aryawiandra/despro-2/brag-output/work/maket.jpg

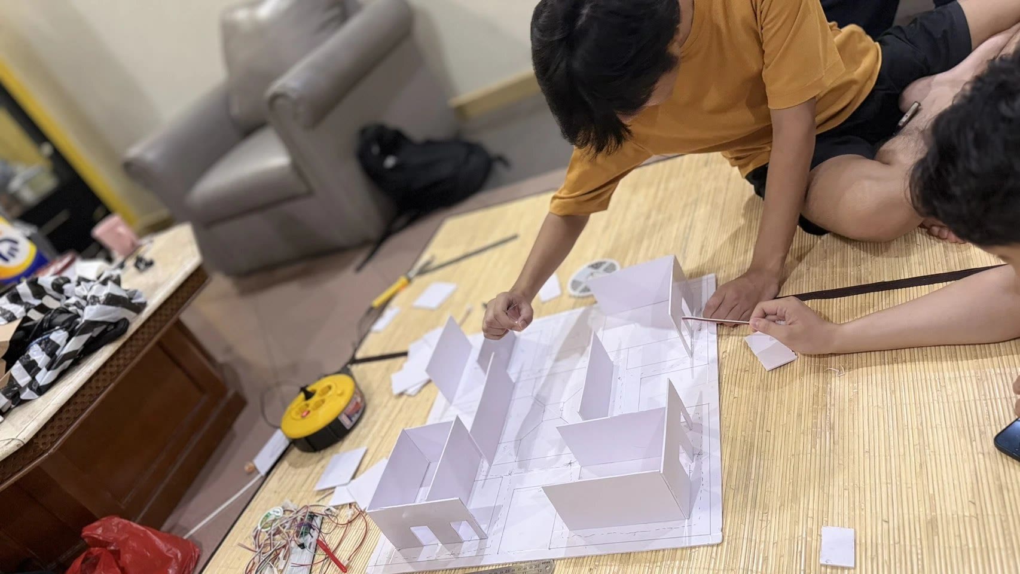
brag-output/work/maket.jpg
