aryawiandra/despro-2/Week4/DOKUM_Maket.jpg

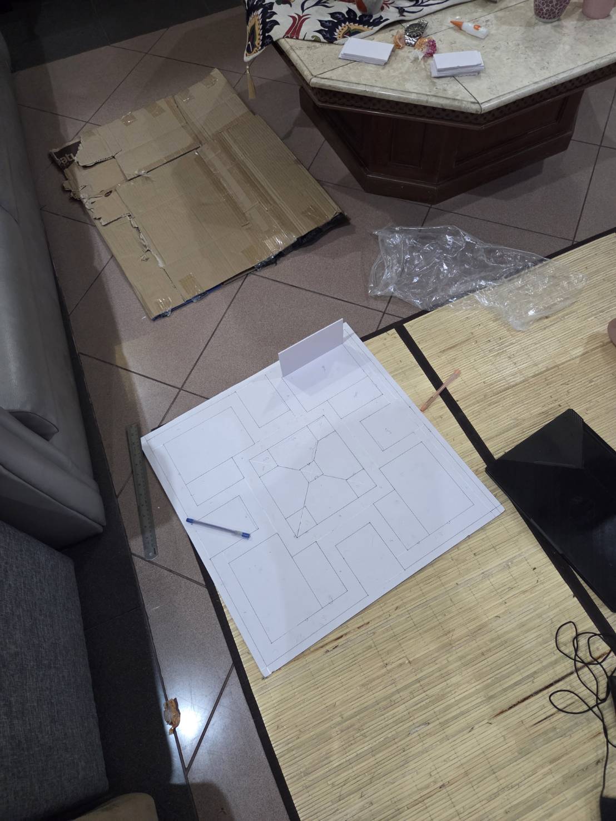
Week4/DOKUM_Maket.jpg
