aryawiandra/despro-2/Week7/README.md

# Week 7 — Navigasi 2 Jalur dengan LED Biasa

LED strip gagal, jadi diganti **LED biasa**. Logic tidak berubah dari
`Week6/espnow/tes_2jalur_*` (ESP-NOW, sender → receiver):

| Kondisi | LED Jalur 1 | LED Jalur 2 |
|---|---|---|
| Tidak ada input / sensor tidak mendeteksi apa-apa | NYALA | NYALA |
| Sensor api jalur 1 kirim `1` (ada api di jalur 1) | **MATI** | nyala |
| Sensor api jalur 2 kirim `1` (ada api di jalur 2) | nyala | **MATI** |
| Kedua jalur terkena api | MATI | MATI (Serial: `[BAHAYA]`) |
| Link ESP-NOW putus > 2 detik | kedip | kedip |

Kode: `led_biasa_2jalur/sender/sender.ino` dan `led_biasa_2jalur/receiver/receiver.ino`
(masing-masing punya `platformio.ini`, buka foldernya di VS Code + PlatformIO).

## Konfigurasi pin

### Receiver (ESP32 #2) — LED jalur

| Fungsi | GPIO ESP32 | Komponen |
|---|---|---|
| LED Jalur 1 | **GPIO 5** | resistor 220 Ω → anoda (+) LED |
| LED Jalur 2 | **GPIO 18** | resistor 220 Ω → anoda (+) LED |
| Ground | **GND** | katoda (−) kedua LED |

```
GPIO5  ──[220Ω]──►|── GND      (LED jalur 1, hijau)
GPIO18 ──[220Ω]──►|── GND      (LED jalur 2, hijau)
```

- Logika **active-HIGH**: pin HIGH (3,3 V) = LED nyala = jalur aman; pin LOW = LED mati = jalur kena api.
- Arus per LED ≈ (3,3 − ~2,0 V) / 220 Ω ≈ 6 mA, aman untuk pin ESP32 (rekomendasi ≤ 12 mA/pin).
- Mau lebih terang / lebih banyak LED per jalur: paralel LED, **tiap LED punya resistor sendiri**,
  dan jaga total arus per pin ≤ ~12 mA (±2 LED per pin). Lebih dari itu pakai transistor (mis. 2N2222/BC547:
  GPIO → 1 kΩ → basis, emitor → GND, LED + resistor ke 5 V lewat kolektor).
- Catu daya: ESP32 dari USB (5 V) atau power bank.

### Sender (ESP32 #1)

| Fungsi | GPIO ESP32 | Keterangan |
|---|---|---|
| Simulasi api | USB / Serial | Tidak butuh wiring — ketik perintah di Serial Monitor (115200) |
| Sensor api jalur 1 (opsional) | **GPIO 32** | Pin **DO** modul flame sensor jalur 1 |
| Sensor api jalur 2 (opsional) | **GPIO 33** | Pin **DO** modul flame sensor jalur 2 |
| Sensor VCC | **3V3** | Jangan 5 V, supaya output DO aman untuk ESP32 |
| Sensor GND | **GND** | |

Sensor hanya dibaca jika `#define USE_FLAME_SENSOR 1` di `sender.ino` (default `0` = simulasi saja).
Output `1` (HIGH) = api terdeteksi. Jika modul sensormu aktif LOW (umum untuk modul flame sensor
LM393), ubah `FLAME_ACTIVE_LEVEL` ke `LOW`.

## Cara simulasi "ada api di jalannya"

1. Upload `receiver.ino` ke ESP32 #2 dan `sender.ino` ke ESP32 #1. Keduanya harus
   `ESPNOW_CHANNEL` sama (1).
2. Buka Serial Monitor sender (115200, line ending **Newline**).
3. Tanpa mengetik apa-apa → kedua LED receiver **nyala**.
4. Ketik `1` (atau `block 1`) → LED jalur 1 **mati** (simulasi api di jalur 1). Ketik `1` lagi / `clear 1` → nyala lagi.
5. Ketik `2` (atau `block 2`) → LED jalur 2 mati. `reset` → kedua nyala lagi.
6. Cabut daya sender > 2 detik → kedua LED receiver berkedip (link putus).

## Catatan

- Kode belum diuji di hardware dari sesi ini (tidak ada ESP32/PlatformIO di lingkungan ini);
  logic diturunkan 1:1 dari Week6 yang sudah dites.
- Folder lama (Week2–Week6) tidak diubah.

---

# Dijkstra + graf 20 jalur (`dijkstra_graph/`)

Graf Week5 (12 junction + 3 exit, 20 jalur, 1 sensor per jalur). Sender menjalankan Dijkstra,
mengirim jalur tercepat ke exit lewat ESP-NOW, receiver menyalakan jalur itu **hijau**.
Input sensor api masih disimulasikan lewat teks di Serial Monitor sender.

- `sender/graph.h` — graf + Dijkstra (C++ murni, sudah diuji di PC)
- `sender/sender.ino` — perintah teks + kirim rute
- `receiver/receiver.ino` — nyalakan jalur rute; `USE_ADDRESSABLE` 0 = LED biasa, 1 = strip addressable

## Perintah di Serial Monitor sender (115200, Newline)

| Perintah | Arti |
|---|---|
| `room 4` | ruangan asal 0–7 (0,1=j1  2,3=j5  4,5=j8  6,7=j11) |
| `start j5` | atau pilih node asal langsung (j1–j12) |
| `block j1-j2` / `block 1` | sensor jalur itu = 1 (ada api), jalur dibuang dari graf |
| `clear j1-j2` | api padam |
| `reset` | semua jalur aman |
| `edges` | daftar 20 jalur: nomor, nama, bobot, status |
| `list` | rute sekarang |

Tiap perubahan: Dijkstra ulang → kirim ke receiver. Jika semua rute ke exit tertutup, semua jalur mati
dan Serial menampilkan `[BAHAYA]`.

## Demo cepat dengan 2 LED (GPIO 5 dan 18, wiring sama seperti di atas)

1. `room 0` → rute j1>j3>j2>e1 (bobot 40). LED GPIO 18 (jalur #2 j1-j3) **nyala**.
2. `block j1-j3` → rute pindah j1>j2>e1 (bobot 54). LED GPIO 18 **mati**, LED GPIO 5 (jalur #1 j1-j2) **nyala**.
3. `block j1-j2` → semua jalan dari j1 tertutup, kedua LED mati, `[BAHAYA]`.
4. `reset` → kembali ke langkah 1.

## 40 LED per jalur

Panjang tiap jalur beda-beda, sementara diasumsikan **40 LED** (`EDGE_LEN[]` di `receiver.ino`, bisa diubah per jalur).

- **Mode LED biasa (default, `USE_ADDRESSABLE 0`)**: 1 pin GPIO per jalur (tabel `EDGE_PIN[]`, `-1` = tidak dipasang).
  Satu pin tidak kuat menyalakan 40 LED (maks ±12 mA/pin), jadi pin menggerakkan transistor/MOSFET
  (mis. GPIO → 1 kΩ → basis 2N2222, LED hijau + resistor tiap LED ke 5 V lewat kolektor) untuk 1 grup 40 LED.
  20 jalur butuh 20 pin; tabel default hanya mengisi jalur #1 (GPIO5) dan #2 (GPIO18) untuk demo di atas.
- **Mode strip addressable (`USE_ADDRESSABLE 1`)**: semua jalur disambung 1 rantai di GPIO 5 (urutan = nomor jalur),
  total 20 × 40 = 800 LED. Butuh library Adafruit NeoPixel dan catu 5 V terpisah (suntik daya tiap beberapa meter);
  hanya jalur rute yang menyala sehingga arus jauh lebih kecil dari 800 LED penuh.

---

# Dijkstra + LED strip WS2812B (`dijkstra_strip/`)

Versi untuk **LED strip addressable** (pengganti `dijkstra_graph` yang LED biasa). Graf, bobot, dan mapping
ruangan sudah dicocokkan dengan `Week4/graph-visualizer.png` dan `Week5/kodeIntegrasi.cpp` (20 jalur identik).

- `sender/` — baca sensor, Dijkstra di `graph.h`. Jalur yang kena api **merah**; **rute tercepat dari setiap ruangan
  ke exit hijau** (beberapa jalur hijau bersamaan); jalur lain mati.
- `receiver/` — jalur hijau dengan kepala terang yang mengalir searah exit (nyala sekuensial, sesuai proposal).
  Link putus: titik biru redup tiap 10 LED.

Perintah sender dan cara upload sama seperti `dijkstra_graph` (`room 0`, `block j1-j3`, `reset`, ...).
Upload: `cd Week7/dijkstra_strip/receiver && pio run -t upload` (idem `sender`).

## Susunan strip: satu pin per jalur

Tiap jalur = 1 strip terpisah (`EDGE_LEN[i]` LED, sementara 40) dengan **pin data sendiri**, tanpa disambung ke strip lain.
Warna tiap LED ditentukan dari data yang dikirim ke pin itu (hijau, merah, atau mati), jadi pin = jalur.

| Jalur | Strip | Pin ESP32 | Jalur | Strip | Pin ESP32 |
|---|---|---|---|---|---|
| #1 | j1-j2 | **GPIO 4** | #11 | j7-j9 | **GPIO 23** |
| #2 | j1-j3 | **GPIO 5** | #12 | j8-j9 | **GPIO 25** |
| #3 | j2-j3 | **GPIO 13** | #13 | j9-j10 | **GPIO 26** |
| #4 | j2-j12 | **GPIO 14** | #14 | j10-j11 | **GPIO 27** |
| #5 | j3-j4 | **GPIO 16** | #15 | j10-j12 | **GPIO 32** |
| #6 | j4-j5 | **GPIO 17** | #16 | j11-j12 | **GPIO 33** |
| #7 | j4-j6 | **GPIO 18** | #17 | j2-e1 | **GPIO 15** (pin boot) |
| #8 | j5-j6 | **GPIO 19** | #18 | j4-e2 | **GPIO 2** (pin boot, LED onboard) |
| #9 | j6-j7 | **GPIO 21** | #19 | j6-e2 | **GPIO 12** (pin boot) |
| #10 | j7-j8 | **GPIO 22** | #20 | j12-e3 | **GPIO 0** (pin boot, tombol BOOT) |

Tabelnya `EDGE_PIN[]` di `receiver.ino` (indeks = nomor jalur − 1); ganti sesuai pin yang kamu pakai.

- **Keterbatasan ESP32:** hanya 16 pin output yang bersih (4, 5, 13, 14, 16–19, 21–23, 25–27, 32, 33). Empat jalur terakhir
  terpaksa memakai pin boot (15, 2, 12, 0). Itu aman selama DIN strip tidak menarik pin ke level tinggi saat reset
  (DIN WS2812B berimpedansi tinggi, ditambah resistor 330 Ω). Kalau **upload gagal** atau ESP32 tidak mau boot,
  cabut kabel data dari GPIO 0, 2, dan 12 sementara.
- **Pin yang jangan dipakai:** GPIO 1 dan 3 (USB serial), 6–11 (flash), 34–39 (hanya input). Kode menolak pin yang tidak valid
  atau ganda dan menampilkan pesan di Serial.
- **Driver output:** library Adafruit NeoPixel hanya bisa melayani 8 pin sekaligus, jadi file ini memakai driver bit-bang
  paralel sendiri yang mengirim ke 20 pin serentak (±1,2 ms per update untuk 40 LED, interrupt dimatikan sebentar).
  Logika bit/pin sudah diuji di PC, tetapi **timing sinyal belum bisa diuji tanpa strip dan ESP32 asli**. Kalau LED berkedip
  acak atau salah warna, lihat bagian "Kalau LED aneh" di bawah.
- **Mode cadangan (`OUTPUT_MODE 0`):** strip digabung dalam rantai DOUT → DIN, tiap rantai 1 pin (`CHAINS[]`), memakai
  library Adafruit (maks 8 rantai). Berguna kalau kekurangan pin.
- Arah data tiap strip = dari node pertama ke node kedua nama jalurnya (jalur #1 mengalir dari j1 ke j2). Jika strip dipasang
  kebalikannya, set `EDGE_REVERSED[i] = true`; animasi tetap searah rute.
- Panjang beda tiap jalur: ubah `EDGE_LEN[i]` (maks `MAX_EDGE_LEN` = 64 LED per jalur).

## Konfigurasi pin dan listrik (receiver)

| Sambungan | Ke |
|---|---|
| ESP32 GPIO sesuai tabel di atas | resistor 330 Ω lalu **DIN** strip jalur yang sesuai (20 kabel data) |
| ESP32 **GND** | GND semua strip **dan** GND catu 5 V (satu ground) |
| Catu **5 V** | +5V tiap strip, langsung dari rel catu (bukan dari pin ESP32) |
| Kapasitor 1000 µF 6,3 V+ | antara +5V dan GND di catu (ESP32 tetap dari USB) |

- Data 3,3 V dari ESP32 biasanya cukup untuk kabel pendek. Kalau LED berkedip acak atau salah warna, pasang level shifter
  (74HCT245 atau 74AHCT125) di jalur data.
- Catu 5 V 30 A sesuai proposal. Hanya jalur hijau/merah yang menyala dan `LED_BRIGHTNESS` 60/255, jadi arus nyata jauh
  di bawah 800 LED penuh (±16 A).

**Kalau LED aneh:** (1) pastikan GND catu dan GND ESP32 tersambung; (2) pasang resistor 330 Ω di tiap kabel data;
(3) coba level shifter 74HCT245; (4) kurangi `LED_BRIGHTNESS`; (5) uji dulu 1 strip di GPIO 4 (jalur #1).

## Parameter di `receiver.ino`

`ANIMATE` (1 = kepala berjalan, 0 = hijau diam), `CHASE_LEN`, `CHASE_STEP_MS`, `SHOW_BLOCKED_RED`
(1 = jalur kena api merah), `LED_BRIGHTNESS`.

## Tes cepat dengan 1 strip pendek

Tanpa merakit 20 jalur: sambungkan **1 strip** (mis. 40 LED) ke **GPIO 4** (jalur #1).
Di sender: `block j1-j3` → jalur #1 (j1>j2) menyala hijau dengan kepala berjalan. `reset` → jalur #1 mati lagi (karena j1>j3
kembali jadi pilihan terbaik). Jalur #2 (j1-j3) merah hanya terlihat bila strip kedua dipasang di GPIO 5.

Logic diuji di PC (Dijkstra, urutan/arah rute, render pixel receiver, link putus); belum diuji di ESP32 asli.

---

# KONFIGURASI AKHIR — `dijkstra_strip` dengan 20 sensor api (2 ESP32)

Alur: 20 sensor api (1 per jalur, langsung ke GPIO, tanpa multiplexer) → **ESP32 #1 sender** (baca sensor, Dijkstra) → ESP-NOW → **ESP32 #2 receiver**
(LED strip 20 jalur × 40 LED). Jalur rute hijau, jalur kena api dibuang dari graf dan rute otomatis dihitung ulang.

## ESP32 #1 — SENDER (20 sensor langsung ke GPIO + Dijkstra)

Tanpa multiplexer: tiap sensor api (pin **DO** modul) disambung ke **1 pin GPIO** sendiri. Tabelnya ada di
`SENSOR_PIN[]` di `sender.ino` (indeks = nomor jalur − 1).

| Jalur | Sensor di | GPIO | Jalur | Sensor di | GPIO |
|---|---|---|---|---|---|
| #1 | j1-j2 | **4** | #11 | j7-j9 | **25** |
| #2 | j1-j3 | **13** | #12 | j8-j9 | **26** |
| #3 | j2-j3 | **14** | #13 | j9-j10 | **27** |
| #4 | j2-j12 | **16** | #14 | j10-j11 | **32** |
| #5 | j3-j4 | **17** | #15 | j10-j12 | **33** |
| #6 | j4-j5 | **18** | #16 | j11-j12 | **34** * |
| #7 | j4-j6 | **19** | #17 | j2-e1 | **35** * |
| #8 | j5-j6 | **21** | #18 | j4-e2 | **36 (VP)** * |
| #9 | j6-j7 | **22** | #19 | j6-e2 | **39 (VN)** * |
| #10 | j7-j8 | **23** | #20 | j12-e3 | **15** ** |

\* GPIO 34, 35, 36, 39 hanya input dan **tidak punya pull-up internal**: pasang resistor **10 kΩ dari pin itu ke 3V3**
(4 resistor). Sensor lain memakai pull-up internal ESP32 (`INPUT_PULLUP`).
\** GPIO 15 adalah pin strapping: aman karena sensor aktif LOW dan idle-nya HIGH saat boot (kalau ada api saat boot,
paling-paling log boot di Serial tidak tampil). Pin yang sengaja **tidak dipakai**: 0, 1, 2, 3, 5, 6–12 (boot, UART USB, flash).

Tiap modul sensor: `VCC` → rel 3,3 V, `GND` → GND, `DO` → GPIO di tabel (pin `AO` tidak dipakai). Modul umumnya
**aktif LOW** (DO = 0 saat ada api), sesuai `SENSOR_ACTIVE_LEVEL LOW`; kalau modulmu aktif HIGH, ubah ke `HIGH`.
Cek label pin di board-mu: beberapa board 30-pin tidak memunculkan semua GPIO di atas (mis. 36/39 berlabel VP/VN).
Pin bisa diganti seenaknya di `SENSOR_PIN[]` (hindari pin terlarang di atas).

**Catatan daya sensor:** 20 modul ≈ 15–20 mA tiap modul ≈ 0,3–0,4 A. Itu terlalu berat untuk regulator 3V3 di board
ESP32 saat WiFi aktif. Pakai regulator/buck **3,3 V terpisah (≥1 A)** dari catu 5 V untuk rel sensor, GND-nya
**disambung** ke GND ESP32. Jangan beri sensor 5 V: output DO bisa 5 V dan melebihi batas pin ESP32 (3,3 V).
Kabel: 20 sensor × 3 kawat; pakai terminal block / PCB bolong untuk rel 3,3 V dan GND bersama.

Sensor yang belum dipasang: set `-1` di `SENSOR_PIN[]` untuk jalur itu (tidak dibaca, selalu "aman").

## ESP32 #2 — RECEIVER (LED strip)

20 strip, **1 pin data per strip** (tabel pin di bagian "Susunan strip: satu pin per jalur"): GPIO → resistor 330 Ω → DIN strip.
GND ESP32 disambung ke GND semua strip dan GND catu 5 V. Strip dapat +5V langsung dari catu 5 V (30 A di proposal), kapasitor
1000 µF antara +5V dan GND. Tiap jalur 40 LED (`EDGE_LEN[]`, `EDGE_REVERSED[]` bila ada strip terpasang kebalikan).
ESP32 receiver cukup dari USB.

## Input ruangan asal

Default (`room all`): rute tercepat dari setiap ruangan (0–7, lewat junction j1, j5, j8, j11) ke exit dihitung sekaligus,
jadi tidak perlu memilih ruangan — 10 jalur hijau saat aman, dan berubah otomatis saat ada api.
Serial sender mencetak rute tercepat **tiap ruangan** ke exit terdekatnya beserta bobotnya (bobot jalur + 1 untuk penghubung ruangan), mis. `Ruang 0: j1 > j3 > j2 > e1 (bobot 41)`. Untuk melihat rute satu ruangan saja: `room N`
(0,1 → j1; 2,3 → j5; 4,5 → j8; 6,7 → j11) atau `start j5`; `room all` kembali ke default.
Ubah default lewat `DEFAULT_SHOW_ALL` di `sender.ino`. Junction yang terputus dari semua exit dicetak di Serial
(`Ruangan di junction ini TERPUTUS dari exit`).

## Upload dan jalankan

```
cd "Week7/dijkstra_strip/receiver" && pio run -t upload      # colok ESP32 receiver
cd "Week7/dijkstra_strip/sender"   && pio run -t upload && pio device monitor   # colok ESP32 sender
```

Perintah di monitor sender: `sensors` (bacaan mentah 20 sensor), `edges`, `list`, `room N`, serta simulasi tanpa
sensor `block j1-j3` / `clear j1-j3` / `reset`.

## Urutan tes sebelum demo

1. **Sensor:** ketik `sensors` di monitor sender. Semua jalur harus `aman`. Dekatkan api ke satu sensor: baris jalur itu
   jadi `API` dan monitor menampilkan `[SENSOR] api di: ...`. Kalau ada jalur yang `API` padahal tidak ada api: cek pull-up
   10 kΩ (untuk GPIO 34/35/36/39), polaritas `SENSOR_ACTIVE_LEVEL`, atau pin yang salah sambung.
2. **Rute:** tanpa api, 10 jalur hijau (j1>j3, j3>j2, j2>e1, j5>j4, j4>e2, j8>j7, j7>j6, j6>e2, j11>j12, j12>e3). Dekatkan api ke sensor j1-j3 → jalur #2 **merah**
   dan j1 berpindah ke j1>j2 (hijau) dalam < 1 detik.
3. **Receiver:** jalur hijau dengan kepala terang mengalir menuju exit; jalur api merah; jalur lain mati.
4. **Semua tertutup:** api di semua jalan keluar (j2-e1, j4-e2, j6-e2, j12-e3) → `[BAHAYA]` di sender, tidak ada jalur hijau, jalur api merah.
5. **Link putus:** cabut sender > 2 detik → receiver menampilkan titik biru redup di tiap jalur.

Logic (Dijkstra, scan + debounce sensor, pemetaan pin ke jalur, render receiver) sudah diuji di PC dengan mock;
rangkaian dan strip asli belum diuji di sesi ini.

---

# UJI 5 STRIP (`dijkstra_5jalur/`) — peta lengkap, 5 strip LED, 5 pin, 5 sensor

Folder `dijkstra_5jalur/` adalah **kode baru khusus uji 5 jalur / 5 pin**. Kode 20 jalur (`dijkstra_strip/`), `dijkstra_graph/`,
dan `led_biasa_2jalur/` tidak diubah.

**Cara kerja:** Dijkstra tetap berjalan di **peta lengkap 20 jalur** (sender, `graph.h`). Strip LED fisik hanya ada di 5 jalur
dengan panjang berbeda, dan receiver hanya menampilkan 5 jalur itu. Sensor api asli juga hanya di 5 jalur itu.

**Input api HANYA dari sensor AO.** Simulasi lewat teks (`block` / `clear` / `reset`) dimatikan secara default
(`ALLOW_TEXT_SIM 0` di `sender.ino`) dan menjawab pesan penolakan. Jalur tanpa sensor tidak pernah dianggap kena api, jadi
hanya api di 5 jalur bersensor yang mengubah rute. Untuk uji tanpa sensor, set `ALLOW_TEXT_SIM 1` lalu upload ulang sender.

| Jalur | Nama | Bobot | LED | Strip (receiver) | Sensor api (sender) |
|---|---|---|---|---|---|
| #3 | j2-j3 | 12 | **7** | **GPIO 4** → 330 Ω → DIN | **GPIO 32** ← AO |
| #11 | j7-j9 | 12 | **8** | **GPIO 5** → 330 Ω → DIN | **GPIO 33** ← AO |
| #15 | j10-j12 | 12 | **8** | **GPIO 13** → 330 Ω → DIN | **GPIO 34** ← AO |
| #18 | j4-e2 | 6 | **6** | **GPIO 14** → 330 Ω → DIN | **GPIO 35** ← AO |
| #19 | j6-e2 | 6 | **5** | **GPIO 18** → 330 Ω → DIN | **GPIO 36 (VP)** ← AO |

Total 34 LED. Panjang LED ada di `STRIPS[]` (`receiver.ino`); pin sensor di `SENSOR_PIN[]` (`sender.ino`).
GPIO 16 dan 17 tidak dipakai (berlabel RX2 / TX2 di banyak board).

## Tampilan

| Kondisi jalur | Tampilan strip |
|---|---|
| Aman, menuju exit (rute tercepat dari ruangan) | **Hijau** redup + kepala terang yang berjalan sekuensial searah exit |
| Kena api (sensor atau teks = 1) | **Merah berkedip** (nyala 400 ms, padam 400 ms) |
| Aman tapi bukan rute | Mati |
| Link putus > 2 detik | Titik biru redup tiap 10 LED |

Parameter di `receiver.ino`: `BLINK_MS`, `ANIMATE` (0 = hijau diam), `CHASE_LEN`, `CHASE_STEP_MS`, `LED_BRIGHTNESS`.

## Skenario (hasil tes di PC; `room all`, semua ruangan dipandu ke exit terdekat)

Kolom pertama menyebut sumber api. Baris bertanda *(teks)* hanya bisa dicoba dengan `ALLOW_TEXT_SIM 1`, karena jalur itu tidak punya sensor.

| Api di (cara) | Strip hijau | Strip merah berkedip | Keterangan |
|---|---|---|---|
| tanpa api | #3, #18, #19 | – | ruang 0,1: j1>j3>j2>e1; ruang 2,3: j5>j4>e2; ruang 4,5: j8>j7>j6>e2 |
| j6-j7 (#9, teks) | #3, #11, #15, #18 | – | ruang 4,5 pindah ke e3 lewat j8>j7>j9>j10>j12>e3; #19 mati |
| j7-j8 (#10, teks) | #3, #15, #18 | – | ruang 4,5 lewat j8>j9>j10>j12>e3 |
| j2-e1 (#17, teks) | #18, #19 | – | ruang 0,1 pindah lewat j3>j4>e2; #3 mati |
| j4-e2 (#18, sensor) | #3, #19 | #18 | ruang 2,3 lewat j5>j4>j6>e2 |
| j6-e2 (#19, sensor) | #3, #18 | #19 | ruang 4,5 lewat j8>j7>j6>j4>e2 |
| j4-e2 dan j6-e2 | #3 | #18, #19 | tinggal jalur ke e1 dan e3 |

## Rangkaian ESP32 #2 — RECEIVER (5 strip)

| Dari | Ke |
|---|---|
| GPIO 4 | resistor 330 Ω → **DIN** strip #3 (j2-j3, 7 LED) |
| GPIO 5 | resistor 330 Ω → **DIN** strip #11 (j7-j9, 8 LED) |
| GPIO 13 | resistor 330 Ω → **DIN** strip #15 (j10-j12, 8 LED) |
| GPIO 14 | resistor 330 Ω → **DIN** strip #18 (j4-e2, 6 LED) |
| GPIO 18 | resistor 330 Ω → **DIN** strip #19 (j6-e2, 5 LED) |
| GND ESP32 | GND semua strip |
| Pin VIN / 5V ESP32 (rel USB 5 V) | +5V semua strip (paralel) |
| Kapasitor 470–1000 µF | antara +5V dan GND di dekat strip (kaki panjang ke +5V) |
| USB ESP32 | laptop |

Arah data strip = dari node pertama ke node kedua nama jalur (#3 mengalir dari j2 ke j3). Kalau terpasang kebalikannya,
set `reversed = true` di `STRIPS[]`. Kalau LED berkedip acak atau salah warna: pasang level shifter 74HCT245 di tiap kabel data.

## Rangkaian ESP32 #1 — SENDER (5 sensor, pin AO analog)

| Sensor di jalur | Pin **AO** sensor ke |
|---|---|
| #3 j2-j3 | GPIO 32 |
| #11 j7-j9 | GPIO 33 |
| #15 j10-j12 | GPIO 34 |
| #18 j4-e2 | GPIO 35 |
| #19 j6-e2 | GPIO 36 (berlabel VP / SVP) |
| VCC semua sensor | **3V3** ESP32 (jangan 5 V) |
| GND semua sensor | GND ESP32 |

- **Pin harus ADC1** (GPIO 32, 33, 34, 35, 36, 39). Pin ADC2 (4, 12–15, 25–27) tidak bisa dibaca analog saat WiFi/ESP-NOW aktif,
  dan sender memakai ESP-NOW. Cadangan: GPIO 39 (berlabel VN / SVN). Tidak perlu pull-up. Kode memberi peringatan di Serial
  kalau ada pin sensor yang bukan ADC1.
- **VCC sensor harus 3,3 V**: pada 5 V pin AO bisa mencapai 5 V dan merusak ADC ESP32. Pin `DO` tidak dipakai.
- **Ambang api**: nilai ADC 12-bit (0–4095). Seperti `Week4/kodeUpdated.cpp`, api bila nilai **< 1500** (`SENSOR_FIRE_BELOW`);
  kembali aman bila nilai **> 1800** (`SENSOR_CLEAR_ABOVE`, histeresis anti-kedip). Tiap scan memakai rata-rata 8 pembacaan,
  dan status baru berubah setelah 3 scan berturut-turut (±150 ms).
- **Kalibrasi**: ketik `sensors` di Serial Monitor sender untuk melihat nilai ADC tiap sensor, misalnya
  `#19 j6-e2 AO GPIO 36 nilai=3900 (api bila < 1500)`. Catat nilai saat tanpa api dan saat api didekatkan, lalu atur
  `SENSOR_FIRE_BELOW` / `SENSOR_CLEAR_ABOVE` di `sender.ino` di antara kedua nilai itu. Tiap modul bisa berbeda.

Jalur lain (tanpa sensor, pin = -1) tidak pernah dianggap kena api (kecuali `ALLOW_TEXT_SIM 1`).

Perintah sender (Serial Monitor 115200, Newline): `room all`, `room N`, `start <node>`, `edges`, `sensors` (nilai ADC), `list`, `help`.
(`block`, `clear`, `reset` hanya aktif bila `ALLOW_TEXT_SIM 1`.)
Upload: `cd Week7/dijkstra_5jalur/receiver && pio run -t upload` (idem `sender`).

## Pengiriman ESP-NOW (tidak spam)

Sender **tidak mengirim terus-menerus**. Paket dikirim hanya saat:
- ada perubahan (sensor api berubah atau perintah teks seperti `block` / `clear` / `reset` / `room`),
- sender baru menyala,
- receiver meminta data (receiver baru menyala atau di-reset).

Tiap kejadian dikirim **3 kali berselang 100 ms** (`SEND_REPEATS`, `SEND_REPEAT_MS`), karena ESP-NOW broadcast tidak ada ACK
dan 1 paket bisa hilang. Setelah itu sender diam. Hasil tes di PC: boot 3 paket, idle 2 menit 0 paket, tiap perubahan 3 paket.
`list`, `edges`, `sensors` tidak mengirim apa pun. Pesan `SEND ERROR` dibatasi maksimal 1× per 5 detik.

Receiver yang baru menyala meminta status ke sender (paket 1 byte `REQUEST_MAGIC`, tiap 1,5 detik) **hanya selama belum ada
data**, lalu berhenti. Jadi receiver yang dinyalakan belakangan tetap langsung menampilkan kondisi terbaru.

Akibatnya **tidak ada deteksi link putus** (receiver tidak tahu kalau sender mati). Kalau butuh: di sender set `HEARTBEAT_MS 1000`
dan di receiver `LINK_TIMEOUT_MS 3500`; strip akan menampilkan titik biru redup bila sender tidak terdengar.

## Daya: cukup dari laptop?

**Ya, untuk uji ini cukup dari USB laptop**, karena hanya 34 LED. Perkiraan (WS2812B, `LED_BRIGHTNESS` 60/255, 20 mA per warna
pada kecerahan penuh):

| Beban | Arus kira-kira |
|---|---|
| 34 LED merah menyala semua (skenario terburuk) | ±0,16 A |
| Hijau redup + kepala terang (normal) | ±0,05–0,1 A |
| LED mati (±1 mA/LED) | ±0,03 A |
| ESP32 receiver (WiFi) | ±0,15–0,25 A |
| **Total terburuk receiver** | **±0,45 A** (di bawah 0,5 A port USB 2.0) |
| ESP32 sender + 5 sensor | ±0,35 A |

Syaratnya `LED_BRIGHTNESS` tetap ≤ 60. Kalau dinaikkan ke 255, merah penuh 34 LED bisa menarik ±0,7 A dan melewati batas USB.
Kalau ESP32 receiver reset sendiri atau LED berkedip acak, pakai power bank atau catu 5 V ≥ 1 A untuk strip (GND disambung ke ESP32).
Angka di atas perkiraan dari datasheet, bukan hasil ukur.

---

# UJI 3 JALUR (`dijkstra_3jalur/`)

Turunan `dijkstra_5jalur/`: **3 strip LED dan 3 sensor api asli (pin AO)**. **Input api hanya dari sensor AO**:
simulasi teks dimatikan (`ALLOW_TEXT_SIM 0` di `sender.ino`), jalur tanpa sensor tidak pernah dianggap kena api. Dijkstra memakai peta lengkap 20 jalur; kode 5 jalur dan
20 jalur tidak diubah.

| Sensor | Jalur | LED | Pin strip (receiver) | Pin sensor AO (sender) |
|---|---|---|---|---|
| 1 | #3 j2-j3 | 7 | **GPIO 5 (D5)** → 330 Ω → DIN | **GPIO 32** |
| 2 | #18 j4-e2 | 6 | **GPIO 13 (D13)** → 330 Ω → DIN | **GPIO 33** |
| 3 | #19 j6-e2 | 5 | **GPIO 14 (D14)** → 330 Ω → DIN | **GPIO 34** |

Total 18 LED. Receiver: GND bersama, +5 V dari USB, kapasitor 470–1000 µF. Sender: VCC sensor 3,3 V (bukan 5 V), GND bersama,
pin AO ke GPIO 32/33/34 (ADC1, tanpa pull-up). Api bila nilai ADC < 1500, aman lagi bila > 1800 (`sensors` menampilkan nilai untuk kalibrasi).

Perintah (Serial Monitor 115200, Newline): `sensors` (nilai ADC + status), `room all`, `room N`, `start <node>`, `edges`, `list`, `help`.
`sensor`, `block`, `clear`, `reset` hanya aktif bila `ALLOW_TEXT_SIM 1` lalu upload ulang sender (untuk uji tanpa sensor).
Contoh: api didekatkan ke sensor 3 → jalur #19 merah berkedip, ruang 4,5 pindah rute.

Upload: `cd Week7/dijkstra_3jalur/receiver && pio run -t upload` (idem `sender`).
Sintaks sender dicek dengan compiler PC (mock Arduino); belum dikompilasi PlatformIO dan belum diuji di ESP32 dari sesi ini.

---

# UJI 6 JALUR (`dijkstra_6jalur/`)

Turunan `dijkstra_3jalur/` (kode 3 jalur tidak diubah): **6 strip LED dan 6 sensor api asli (pin AO)**. Power supply 5 V sudah bisa dipakai.
Tiga jalur pertama memakai pin yang sama dengan uji 3 jalur, jadi wiring lama tidak perlu dibongkar; tiga jalur baru ditambahkan.

| Sensor | Jalur | LED | Pin strip (receiver) | Pin sensor (sender) | Keterangan |
|---|---|---|---|---|---|
| 1 | #3 j2-j3 | 7 | **GPIO 5 (D5)** → 330 Ω → DIN | **GPIO 32** | sama dengan uji 3 jalur |
| 2 | #18 j4-e2 | 6 | **GPIO 13 (D13)** → 330 Ω → DIN | **GPIO 33** | sama dengan uji 3 jalur |
| 3 | #19 j6-e2 | 5 | **GPIO 14 (D14)** → 330 Ω → DIN | **GPIO 34** | sama dengan uji 3 jalur |
| 4 | #11 j7-j9 | 8 | **GPIO 4 (D4)** → 330 Ω → DIN | **GPIO 35** (AO) | baru |
| 5 | #15 j10-j12 | 8 | **GPIO 18 (D18)** → 330 Ω → DIN | **GPIO 25** (DO digital) | baru |
| 6 | #20 j12-e3 | 5 | **GPIO 19 (D19)** → 330 Ω → DIN | **GPIO 26** (DO digital) | baru, exit e3 |

Total 39 LED. Perkiraan arus terburuk (merah semua, `LED_BRIGHTNESS` 60) ±0,5 A, diskalakan dari estimasi 0,45 A untuk 34 LED, bukan hasil ukur.
Strip dicatu dari power supply 5 V dengan GND bersama ESP32 dan kapasitor 470–1000 µF; sensor VCC 3,3 V. Board hanya punya GPIO sampai 35 (tanpa VP/VN = GPIO 36/39) dan ADC2 tidak bisa dibaca saat ESP-NOW aktif, jadi pin AO (ADC1) cuma
GPIO 32, 33, 34, 35 untuk sensor 1-4. Sensor 5 dan 6 dibaca **digital dari pin DO** modul (GPIO 25 dan 26): tanpa ADC, ambang api diatur
dengan potensiometer di modul (putar sampai LED DO menyala saat ada api). Modul LM393 umumnya DO = LOW saat api; bila terbalik ubah
`SENSOR_DIGITAL_FIRE_LEVEL` di `sender.ino`. Sensor 5-6 tidak punya nilai ADC, jadi `sensors` menampilkan status pin HIGH/LOW.
Alternatif bila perlu sensor analog lebih banyak: multiplexer CD74HC4067 (sudah ada di rancangan proposal) pada satu pin ADC1.

Pilihan jalur #11, #15, #20 adalah usulan (tiga exit tercakup: e1 lewat jalur lain, e2 lewat #18/#19, e3 lewat #20). Mau jalur lain: ubah `STRIPS[]` di
`receiver.ino` serta `SENSOR_EDGE[]` dan `SENSOR_PIN[]` di `sender.ino`.

Perintah tambahan dibanding 3 jalur: `sensor <1-6> 1|0` (simulasi teks sensor 1..6) dan `sensors` menampilkan 6 nilai ADC.
Upload: `cd Week7/dijkstra_6jalur/receiver && pio run -t upload` (idem `sender`).
Sintaks sender dan receiver dicek dengan compiler PC (mock Arduino, tanpa error/warning); belum dikompilasi PlatformIO dan belum diuji di ESP32 dari sesi ini.
