aryawiandra/despro-2/Week7/Individu_LAPORAN PEKANAN.docx

# LAPORAN PEKANAN INDIVIDU

## Capstone Project Desain Proyek 2

### A. Identitas Mahasiswa

Item | Keterangan
Nama | Muhammad Arya Wiandra Utomo
NPM | 2306218295
Program Studi | Teknik Komputer
Kelompok | 21
Judul Proyek | SAFE-EXIT: Adaptive Fire-Evacuation Path Lighting System
Pekan ke- | 7
Periode Tanggal | 5 – 10 Oktober 2026
Dosen Pembimbing | Dr. Eng. Mia Rizkinia, S.T., M.T.

## B. Target Mingguan

Target yang direncanakan pada awal pekan berdasarkan WBS dan pembagian tugas kelompok.

No | Target Pekerjaan | Luaran yang Diharapkan | Status
1 | Menyolder LED strip WS2812B untuk maket | Seluruh LED strip tersolder | ☑ Selesai
2 | Menyelesaikan kode prototipe penuh dan scaling ke 20 jalur | Kode sender + receiver 20 jalur, versi uji 5 jalur dan 3 jalur di repository | ☑ Selesai
3 | Menguji integrasi penuh 20 jalur dengan power supply | Seluruh jalur menyala sesuai rute | ☐ Belum
4 | Menguji 3 jalur (sensor, Dijkstra, ESP-NOW, LED) | Hasil uji 3 jalur | ☑ Selesai
5 | Mendokumentasikan spesifikasi sensor api | Tabel spesifikasi sensor di laporan | ☑ Selesai

## C. Logbook Aktivitas Harian

Hari/Tanggal | Uraian Aktivitas | Waktu (Jam) | Bukti/Dokumen
Senin, 5 Oktober 2026 | Rapat tim awal pekan; breakdown tugas Pekan 7 (solder LED, kode prototipe, integrasi) | 2 | Catatan rapat
Selasa, 6 Oktober 2026 | Menyolder LED strip dan kabel data bersama tim | 3 | Foto LED tersolder (Gambar 1)
Rabu, 7 Oktober 2026 | Menyolder LED strip; menyiapkan pemetaan pin 20 jalur | 3 | Foto LED tersolder; tabel pin
Kamis, 8 Oktober 2026 | Menyusun kode Dijkstra 20 jalur dan receiver strip per jalur | 4 | Source code Week7/dijkstra_strip
Jumat, 9 Oktober 2026 | Kendala: arus uji 5 jalur kurang kuat dan konektor power supply bermasalah; memutuskan uji disederhanakan menjadi 3 jalur | 3 | Catatan kendala
Sabtu, 10 Oktober 2026 | Menulis dan menguji kode 3 jalur (sensor AO GPIO 32/33/34, strip GPIO 5/13/14, ESP-NOW hemat paket, merah berkedip); menyusun spesifikasi sensor, laporan, dan PPT | 6 | Commit Week7/dijkstra_3jalur (Gambar 3); laporan

### Total Jam Kerja Minggu Ini : 21 Jam

## D. Realisasi Pekerjaan

### 1. Aktivitas yang Berhasil Diselesaikan

- Ikut menyolder LED strip WS2812B untuk 20 jalur sampai selesai.
- Menyelesaikan kode prototipe penuh dan scaling ke 20 jalur: graf 15 simpul / 20 jalur, Dijkstra multi-sumber dari exit, rute tercepat tiap ruangan, receiver strip per jalur dengan kepala terang bergerak ke exit, dan pengiriman ESP-NOW.
- Menyusun versi uji 5 jalur (dijkstra_5jalur) dan versi uji 3 jalur (dijkstra_3jalur): Dijkstra pada peta lengkap, 3 strip fisik (18 LED) pada GPIO 5, 13, 14, 3 sensor api via pin AO ADC1 (GPIO 32, 33, 34) dengan ambang 1500 / histeresis 1800, merah berkedip, dan ESP-NOW yang hanya mengirim saat ada perubahan. Input api hanya dari sensor AO (simulasi teks dimatikan).
- Menguji 3 jalur sampai berhasil (sensor hingga LED) setelah uji 5 jalur terkendala arus catu yang kurang kuat dan konektor power supply; mendokumentasikan spesifikasi sensor api; menyusun laporan dan PPT Pekan 7.

### 2. Luaran yang Dihasilkan

- Source code Week7/dijkstra_strip (20 jalur), Week7/dijkstra_5jalur, dan Week7/dijkstra_3jalur (uji 3 jalur berhasil) di repository tim
- LED strip 20 jalur yang telah disolder (kontribusi tim)
- README Week7: pemetaan pin, rangkaian, perkiraan daya, skenario uji
- Spesifikasi sensor api (tabel pada bagian E laporan ini)
- Laporan kelompok, laporan individu, dan PPT Pekan 7

## E. Capaian Teknis Mingguan

### Komponen/Subsistem yang Dikerjakan (pilih sesuai tugas)

Subsistem | Target | Realisasi | Persentase
Hardware | Menyolder LED strip dan menyiapkan rangkaian maket | LED strip 20 jalur selesai disolder; rangkaian 3 jalur berhasil; uji 5 jalur terkendala arus; 20 jalur menunggu konektor PSU | 70%
Software | Kode prototipe penuh dan scaling 20 jalur | Sender + receiver 20 jalur selesai; versi uji 3 jalur berhasil berjalan | 95%
Mekanik | Pemasangan LED dan sensor pada maket | LED dan sensor 3 jalur siap ditempel pada maket; menunggu penempelan | 30%
Pengujian | Uji integrasi 20 jalur dengan power supply | Uji 3 jalur berhasil; 20 jalur menunggu konektor PSU | 40%
Dokumentasi | Laporan, README, dan PPT Pekan 7 | Selesai (foto uji perlu ditempel) | 100%

### Ringkasan Kemajuan

Pekan ini LED strip selesai disolder dan kode prototipe penuh selesai serta di-scale ke 20 jalur. Uji 5 jalur terkendala karena arus catu kurang kuat dan konektor power supply bermasalah, sehingga pengujian disederhanakan menjadi 3 jalur (18 LED, 3 sensor): strip di GPIO 5, 13, 14 dan sensor AO di GPIO 32, 33, 34. Pada 3 jalur sistem berhasil berjalan dari sensor hingga LED. Sisa pekerjaan adalah menempel LED strip dan sensor 3 jalur pada maket, mengukur jarak deteksi sensor dan daya, serta uji 20 jalur setelah konektor PSU diperbaiki.

### Spesifikasi Sensor Api

Sensor yang dipakai adalah modul flame sensor (LM393) dengan keluaran analog (AO). Nilai spesifikasi modul adalah tipikal datasheet; jarak deteksi aktual perlu diukur pada maket.

Parameter | Spesifikasi
Jenis modul | Modul flame sensor (fotodioda IR + komparator LM393). Keluaran analog (AO) dan digital (DO); yang dipakai: AO
Spektrum cahaya | ±760–1100 nm (inframerah dekat). Peka terhadap nyala api; juga peka IR matahari / lampu pijar
Sudut deteksi | ±60°. Modul diarahkan ke jalur yang dipantau
Jarak deteksi | ±20 cm (api korek) hingga ±80 cm (api lebih besar). Spesifikasi tipikal modul, diatur potensiometer (DO); bukan hasil ukur
Tegangan kerja | 3,3–5 V (dipakai 3,3 V). VCC 3,3 V agar AO tidak melebihi batas ADC ESP32
Pin AO yang dipakai | GPIO 32, 33, 34 (ADC1). Sensor 1/2/3 = jalur #3 / #18 / #19; ADC2 tidak bisa dibaca saat ESP-NOW aktif
Rentang scan ADC | 0–4095 (12 bit), atenuasi 11 dB ≈ 0–3,3 V. Nilai ADC turun saat ada api (aktif rendah)
Ambang deteksi | Api bila ADC < 1500 (≈1,21 V); aman lagi bila > 1800 (≈1,45 V). Histeresis 300 hitungan (≈0,24 V) agar tidak berkedip
Periode scan | 50 ms (20 Hz); rata-rata 8 sampel; konfirmasi 3 scan berturut-turut. Waktu deteksi ±150 ms ditambah kirim ESP-NOW (3x, jeda 100 ms); target ≤ 2 detik
Jarak deteksi terukur | [isi hasil ukur pada maket: … cm]. Perlu diukur dengan api nyata; angka di atas adalah tipikal modul

## F. Permasalahan dan Kendala

No | Kendala | Dampak | Tingkat Risiko
1 | Arus catu pada uji 5 jalur kurang kuat dan konektor power supply bermasalah | 5 jalur tidak dapat dicatu dengan baik; pengujian disederhanakan menjadi 3 jalur | Tinggi
2 | Sensor api fisik hanya 3 jalur pada uji | Hanya 3 jalur yang dapat mendeteksi api; jalur lain tidak pernah dianggap kena api (simulasi teks dimatikan) | Sedang
3 | Kode 20 jalur belum teruji pada beban penuh (arus, drop tegangan, timing data) | Risiko LED berkedip / salah warna baru terlihat saat PSU tersedia | Sedang

### Analisis Penyebab

Arus catu pada uji 5 jalur kurang kuat dan konektor power supply bermasalah, sehingga 5 jalur (34 LED) dan 20 jalur tidak dapat dicatu dengan baik. Dengan 3 jalur (18 LED) dan kecerahan 60/255, beban lebih kecil (estimasi ±0,24 A) dan pengujian berhasil. Pengujian 20 jalur tergantung perbaikan atau penggantian konektor PSU.

## G. Tindakan Korektif dan Solusi

Kendala | Solusi/Tindak Lanjut | PIC | Target Penyelesaian
Kabel PSU tidak bisa dipakai | Perbaiki / ganti konektor PSU; uji 20 jalur dengan power supply 5 V dan ukur arus | Rasyad, Satria | 12 Oktober 2026
Sensor api hanya 3 jalur | Input api hanya dari sensor AO; tambah sensor sesuai jumlah modul yang tersedia; ukur jarak deteksi sensor di maket | Arya, Fido | 14 Oktober 2026
Kode 20 jalur belum teruji beban penuh | Uji bertahap 5 > 10 > 20 jalur; pasang level shifter / resistor 330 Ω bila LED berkedip | Arya, Fido | 15 Oktober 2026

## H. Dokumentasi Kemajuan

- Foto LED strip 20 jalur yang telah disolder (Gambar 1) [tempel foto]
- Foto pengujian 3 jalur (Gambar 2) [tempel foto]
- Source code Week7/dijkstra_3jalur, Week7/dijkstra_5jalur, dan Week7/dijkstra_strip (commit Git, repository tim)

[Tempel foto: LED strip 20 jalur tersolder] | [Tempel foto: pengujian 3 jalur]

## I. Kontribusi Terhadap Tim

### Koordinasi yang Dilakukan

- Rapat tim tanggal: 5 Oktober 2026
- Diskusi teknis: pemetaan pin strip dan sensor, pilihan ADC1 untuk sensor, strategi uji 3 jalur karena arus catu dan konektor PSU, dan pembagian penyolderan
- Koordinasi dengan dosen: belum ada sesi bimbingan tercatat pekan ini; hasil Pekan 7 disiapkan untuk presentasi progres Pekan 8

### Kontribusi Pribadi

Kontribusi seluruh anggota Kelompok 21 pada Pekan 7 berdasarkan pembagian kerja yang disusun ketua kelompok:

No | Nama | Pembagian Kerja | Uraian Kontribusi
1 | Muhammad Arya Wiandra Utomo | Software, Hardware | Software: kode prototipe penuh dan scaling 20 jalur, versi uji 5 dan 3 jalur, pengujian Hardware: ikut menyolder LED; menyusun laporan pekanan, spesifikasi sensor, dan PPT
2 | Fido Wahyu Choirulinsan | Software, Hardware | Software: menyusun dan menguji kode sender/receiver Hardware: ikut menyolder LED strip
3 | Rasendriya Arsanta (ketua) | Software, Koordinasi | Software: ikut menyusun dan menguji kode Koordinasi: koordinasi tim dan PPT
4 | Satria Pakarti Siswantra | Hardware | Hardware: menyolder LED strip, merakit rangkaian sensor 3 jalur Menelusuri konektor PSU
5 | Kemas Rasyad Subhan | Hardware | Hardware: menyolder LED strip dan menyiapkan kabel data tiap jalur Menelusuri konektor PSU

## J. Evaluasi Diri

### Yang Berjalan Baik

- Seluruh LED strip selesai disolder dan kode prototipe penuh selesai (scaling 20 jalur)
- Uji 3 jalur berhasil dari sensor hingga LED sehingga sistem sudah bisa didemonstrasikan
- Pembagian kerja tim jelas (hardware vs software) dan komunikasi lancar

### Yang Perlu Diperbaiki

- Arus catu dan konektor PSU tidak dicek lebih awal sehingga uji 5 dan 20 jalur tertunda
- Kode 20 jalur belum teruji pada hardware dan beban penuh
- Sensor api fisik baru ada untuk 3 jalur; jarak deteksi belum diukur pada maket

### Pelajaran yang Didapat Minggu Ini

- Kebutuhan arus, catu daya, dan konektornya perlu dihitung dan dicek lebih awal, bukan setelah semua LED selesai disolder
- Pengurangan skala uji (20 > 5 > 3 jalur) menjaga kemajuan saat hardware penuh belum siap
- ESP32 hanya bisa membaca ADC1 saat ESP-NOW aktif; pemilihan pin harus ditinjau sebelum wiring

## K. Rencana Pekan Berikutnya

No | Rencana Kegiatan | Target Luaran | Estimasi Jam
1 | Perbaiki / ganti konektor PSU dan uji 20 jalur dengan power supply 5 V | Seluruh jalur menyala sesuai rute; data arus | 5 Jam
2 | Kalibrasi ambang sensor, ukur jarak/sudut deteksi, dan ukur konsumsi daya | Tabel nilai ADC aman/api, jarak deteksi, dan arus | 3 Jam
3 | Tempel LED strip dan sensor 3 jalur pada maket Gedung K | Maket berfungsi dengan 3 jalur (tambah jalur bertahap) | 5 Jam
4 | Uji end-to-end (respons ≤ 2 detik, reroute) dan implementasi relay | Skenario darurat end-to-end berjalan | 5 Jam
5 | Persiapan presentasi progres Pekan 8 | Slide dan demo siap | 3 Jam

## L. Persetujuan

Mahasiswa

Nama: Muhammad Arya Wiandra Utomo

Tanda tangan:

Tanggal: 10 Oktober 2026

Ketua Kelompok

Nama: Rasendriya Arsanta

Tanda tangan:

Tanggal: 10 Oktober 2026

Catatan Pembimbing
