aryawiandra/despro-2/Week7/Kelompok_LAPORAN KEMAJUAN PEKANAN.docx

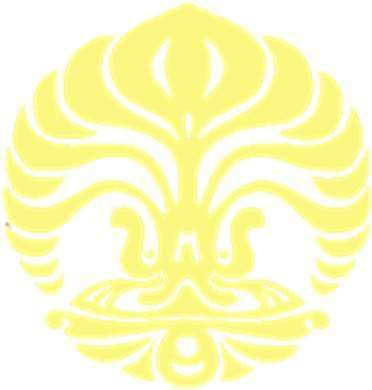
[picture p15: figure]

# LAPORAN KEMAJUAN PEKANAN

## DESAIN PROYEK TEKNIK ELEKTRO, KOMPUTER, BIOMEDIK 2

Judul Proyek : SAFE-EXIT: Adaptive Fire-Evacuation Path Lighting System

Kelompok : 21

Pekan Ke- : 7

Periode : 5 – 10 Oktober 2026

Dosen Pembimbing : Dr. Eng. Mia Rizkinia, S.T., M.T.

Ketua Kelompok : Rasendriya Arsanta

Anggota Kelompok :

- Satria Pakarti Siswantra

- Muhammad Arya Wiandra Utomo

- Kemas Rasyad Subhan

- Fido Wahyu Choirulinsan

# 1. Ringkasan Kemajuan Pekanan

Pekan 7 berfokus pada realisasi hardware dan integrasi prototipe. Seluruh LED strip (20 jalur) sudah selesai disolder, dan kode prototipe penuh sudah selesai dan di-scale ke 20 jalur: firmware sender (graf 15 simpul / 20 jalur, Dijkstra multi-sumber dari exit, pembacaan sensor api) dan receiver (kontrol LED WS2812B per jalur, hijau = rute tercepat dengan kepala terang bergerak ke exit, merah berkedip = jalur terkena api) berkomunikasi lewat ESP-NOW. Uji awal 5 jalur (34 LED, 5 sensor) terkendala karena arus catu kurang kuat dan konektor power supply bermasalah, sehingga pengujian disederhanakan menjadi 3 jalur (18 LED, 3 sensor api): strip di GPIO 5, 13, 14 (D5, D13, D14) receiver dan sensor AO di GPIO 32, 33, 34 sender. Uji 3 jalur berhasil dari sensor hingga LED. LED strip dan sensor 3 jalur tinggal ditempel pada maket; uji 20 jalur dijadwalkan setelah konektor power supply diperbaiki.

# 2. Target Pekan Ini

No | Target | Status
1 | Menyolder seluruh LED strip WS2812B untuk 20 jalur maket | ☑ Tercapai
2 | Menyelesaikan kode prototipe penuh (sender + receiver) dan melakukan scaling ke 20 jalur | ☑ Tercapai
3 | Menguji integrasi pada maket dengan catu daya yang tersedia (disederhanakan dari 20 jalur menjadi 3 jalur) | ☑ Tercapai (3 jalur)
4 | Menguji integrasi penuh 20 jalur dengan power supply 5 V pada maket | ☐ Belum

# 3. Realisasi Kegiatan

No | Kegiatan | Penanggung Jawab | Hasil
1 | Menyolder seluruh LED strip (20 jalur) dan menyiapkan kabel data tiap jalur | Seluruh anggota (fokus: Kemas Rasyad Subhan, Satria Pakarti Siswantra) | Seluruh LED sudah tersolder; siap dipasang pada maket
2 | Menyelesaikan kode prototipe penuh: Dijkstra 20 jalur, pembacaan sensor, receiver strip per jalur, pengiriman ESP-NOW (Week7/dijkstra_strip), versi uji 5 jalur (Week7/dijkstra_5jalur), dan versi uji 3 jalur (Week7/dijkstra_3jalur) | Muhammad Arya Wiandra Utomo, Fido Wahyu Choirulinsan, Rasendriya Arsanta | Kode prototipe penuh + scaling 20 jalur selesai; versi 3 jalur terunggah di repository (Gambar 3)
3 | Mengatasi kendala catu daya: arus pada uji 5 jalur kurang kuat dan konektor power supply bermasalah, sehingga uji disederhanakan menjadi 3 jalur (3 strip, 3 sensor) | Seluruh anggota | Uji 3 jalur berhasil dijalankan; uji 20 jalur menunggu konektor PSU diperbaiki
4 | Pengujian 3 jalur: sensor api, rute Dijkstra, merah berkedip, dan komunikasi ESP-NOW | Muhammad Arya Wiandra Utomo, Fido Wahyu Choirulinsan, Rasendriya Arsanta | Berhasil pada 3 jalur (lihat bagian 7)
5 | Menyusun laporan pekanan dan presentasi (PPT) Pekan 7 | Muhammad Arya Wiandra Utomo, Rasendriya Arsanta | Laporan kelompok, laporan individu, dan PPT selesai
6 | Mendokumentasikan spesifikasi sensor api (spektrum, sudut, jarak, rentang scan ADC, ambang) | Muhammad Arya Wiandra Utomo, Fido Wahyu Choirulinsan | Tabel spesifikasi sensor pada bagian 5; jarak deteksi terukur menunggu uji di maket

# 4. Kemajuan Tiap Anggota

Persentase adalah estimasi penyelesaian tugas pekan ini oleh masing-masing anggota.

Nama | Tugas Pekan Ini | Persentase Penyelesaian
Fido Wahyu Choirulinsan | Hardware: ikut menyolder LED strip Software: menyusun dan menguji kode sender/receiver (Dijkstra, ESP-NOW) | 90%
Kemas Rasyad Subhan | Hardware: menyolder LED strip dan menyiapkan kabel data tiap jalur Masalah catu daya: menelusuri konektor PSU | 85%
Muhammad Arya Wiandra Utomo | Software: kode prototipe penuh dan scaling 20 jalur, versi uji 5 dan 3 jalur, pengujian Hardware: ikut menyolder LED; menyusun laporan pekanan dan PPT | 90%
Rasendriya Arsanta | Software: ikut menyusun dan menguji kode Koordinasi tim sebagai ketua kelompok; PPT | 90%
Satria Pakarti Siswantra | Hardware: menyolder LED strip dan merakit rangkaian sensor 3 jalur Masalah catu daya: menelusuri konektor PSU | 85%

# 5. Hasil Implementasi

### Hardware

- Komponen yang telah direalisasikan:
  - LED strip WS2812B untuk 20 jalur: seluruhnya sudah disolder
  - Rangkaian uji 3 jalur (berhasil): 3 strip (7, 6, 5 LED = 18 LED) pada GPIO 5, 13, 14 (D5, D13, D14) receiver lewat resistor 330 Ω ke DIN, dan 3 sensor api (pin AO) pada ADC1 GPIO 32, 33, 34 sender untuk jalur #3, #18, #19
  - Dua ESP32 (sender dan receiver) berkomunikasi lewat ESP-NOW
  - Uji 5 jalur (34 LED, 5 sensor) tidak dilanjutkan: arus catu kurang kuat dan konektor power supply bermasalah
- Status integrasi:
  - Integrasi 3 jalur berhasil: sensor api sender, Dijkstra, ESP-NOW, dan LED strip receiver
  - Integrasi 20 jalur penuh dengan power supply 5 V belum dapat diuji karena konektor power supply bermasalah
  - Modul relay (simulasi MCB trip), DFPlayer Mini, dan PCB solder permanen belum diintegrasikan
  - LED strip dan sensor 3 jalur siap ditempel pada maket Gedung K

### Software

- Fitur yang telah selesai:
  - Kode prototipe penuh (Week7/dijkstra_strip) dan scaling ke 20 jalur: graf 15 simpul / 20 jalur, Dijkstra multi-sumber dari exit, rute tercepat dari tiap ruangan ke exit
  - Versi uji 3 jalur (Week7/dijkstra_3jalur, turunan dijkstra_5jalur): Dijkstra tetap memakai peta lengkap 20 jalur, strip fisik 3 jalur (#3, #18, #19); sensor api dibaca dari pin AO (ADC1) dengan ambang < 1500 dan histeresis > 1800; hasil sensor asli dan input teks digabung; jalur lain disimulasikan lewat Serial (sensor <1-3> 1|0, block / clear / reset)
  - Tampilan LED: hijau + kepala terang bergerak searah exit (rute), merah berkedip 400 ms (kena api), mati (bukan rute)
  - ESP-NOW hemat: sender mengirim hanya saat ada perubahan (diulang 3x), receiver meminta data saat baru menyala; hasil uji PC: idle 2 menit = 0 paket
- Fitur yang masih dikembangkan:
  - Uji 20 jalur penuh dengan power supply 5 V (menunggu konektor PSU diperbaiki)
  - Pengukuran konsumsi daya aktual dan kalibrasi ambang sensor tiap modul
  - Logika pemutusan listrik utama (simulasi MCB trip via relay)
  - Audio DFPlayer Mini
  - Graf dan rute Lantai 1 dengan 2 gerbang

### Mekanik/Biomedik (jika ada)

- Maket Gedung K: LED strip dan sensor 3 jalur yang sudah berhasil diuji tinggal ditempel pada maket; jalur lain ditambah bertahap setelah catu daya siap

### Spesifikasi Sensor Api

Sensor api yang dipakai pada 3 jalur adalah modul flame sensor (LM393) dengan keluaran analog (AO). Nilai spesifikasi modul adalah tipikal datasheet; jarak deteksi aktual perlu diukur pada maket.

Parameter | Spesifikasi | Keterangan
Jenis modul | Modul flame sensor (fotodioda IR + komparator LM393) | Keluaran analog (AO) dan digital (DO); yang dipakai: AO
Spektrum cahaya | ±760–1100 nm (inframerah dekat) | Peka terhadap nyala api; juga peka IR matahari / lampu pijar
Sudut deteksi | ±60° | Modul diarahkan ke jalur yang dipantau
Jarak deteksi | ±20 cm (api korek) hingga ±80 cm (api lebih besar) | Spesifikasi tipikal modul, diatur potensiometer (DO); bukan hasil ukur
Tegangan kerja | 3,3–5 V (dipakai 3,3 V) | VCC 3,3 V agar AO tidak melebihi batas ADC ESP32
Pin AO yang dipakai | GPIO 32, 33, 34 (ADC1) | Sensor 1/2/3 = jalur #3 / #18 / #19; ADC2 tidak bisa dibaca saat ESP-NOW aktif
Rentang scan ADC | 0–4095 (12 bit), atenuasi 11 dB ≈ 0–3,3 V | Nilai ADC turun saat ada api (aktif rendah)
Ambang deteksi | Api bila ADC < 1500 (≈1,21 V); aman lagi bila > 1800 (≈1,45 V) | Histeresis 300 hitungan (≈0,24 V) agar tidak berkedip
Periode scan | 50 ms (20 Hz); rata-rata 8 sampel; konfirmasi 3 scan berturut-turut | Waktu deteksi ±150 ms ditambah kirim ESP-NOW (3x, jeda 100 ms); target ≤ 2 detik
Jarak deteksi terukur | [isi hasil ukur pada maket: … cm] | Perlu diukur dengan api nyata; angka di atas adalah tipikal modul

# 6. Dokumentasi Hasil

### Foto Kegiatan

[Tempel foto: LED strip 20 jalur yang telah disolder] | [Tempel foto: pengujian 3 jalur (strip menyala hijau/merah)]

Gambar 1. LED strip WS2812B 20 jalur yang telah selesai disolder

Gambar 2. Pengujian 3 jalur: 3 strip LED dan 3 sensor api

### Screenshot Sistem

Gambar 3. Cuplikan kode Week7/dijkstra_3jalur: pembacaan sensor dengan histeresis, pengiriman ESP-NOW, dan tampilan merah berkedip (kode lengkap pada repository tim)

bool fire = wasFire ? (v < SENSOR_CLEAR_ABOVE) : (v < SENSOR_FIRE_BELOW); // histeresis 1500 / 1800

#define SEND_REPEATS 3 // kirim hanya saat ada perubahan, diulang 3x karena broadcast tanpa ACK

bool blinkOn = ((millis() / BLINK_MS) % 2) == 0; // jalur kena api: merah berkedip 400 ms

strips[s]->setBrightness(LED_BRIGHTNESS); // 60/255 agar arus tetap di bawah batas USB

esp_now_send(broadcastMac, (uint8_t *)&pkt, sizeof(pkt)); // sender > receiver

Foto dan tangkapan layar hasil uji pada kondisi nyata perlu ditempel pada Gambar 1 dan 2 sebelum laporan dikumpulkan.

# 7. Pengujian yang Dilakukan

Parameter | Target | Hasil | Status
Penyolderan LED strip 20 jalur | Seluruh LED strip tersolder dan menyala | Seluruh LED strip sudah disolder | ☑ Lulus
Integrasi 3 jalur (sensor, Dijkstra, ESP-NOW, LED) | 3 sensor terbaca; rute hijau dan jalur api merah berkedip pada 3 strip (18 LED) | Berhasil pada 3 jalur sesuai skenario uji | ☑ Lulus
Komunikasi ESP-NOW hemat paket | Paket hanya dikirim saat ada perubahan | Hasil uji PC: boot 3 paket, idle 2 menit 0 paket, tiap perubahan 3 paket | ☑ Lulus
Integrasi penuh 20 jalur dengan power supply 5 V | Seluruh 20 jalur menyala sesuai rute dan jalur api | Belum diuji; konektor power supply bermasalah | ☑ Tidak
Konsumsi daya | Arus di bawah kapasitas catu daya | Belum diukur (estimasi proporsional dari datasheet 34 LED ±0,45 A: ±0,24 A untuk 18 LED pada receiver) | ☑ Tidak
Jarak dan sudut deteksi sensor api | Api terdeteksi pada jarak sesuai spesifikasi modul | [isi hasil ukur: … cm, sudut …°] | ☐ Perlu data

### Analisis Singkat

Pengujian pekan ini dibatasi pada 3 jalur: uji 5 jalur terkendala karena arus catu kurang kuat dan konektor power supply bermasalah. Pada 3 jalur (18 LED, kecerahan 60/255) integrasi sensor, Dijkstra, ESP-NOW, dan LED berhasil; jalur lain disimulasikan lewat Serial. Hasil ini belum mewakili 20 jalur: beban arus penuh, kestabilan sinyal data pada strip panjang, dan penurunan tegangan hanya dapat diuji setelah catu daya yang memadai tersedia.

Pengujian yang tertunda: integrasi 20 jalur penuh dengan power supply, pengukuran konsumsi daya, pengukuran jarak/sudut deteksi sensor pada maket, waktu respons deteksi ke LED, dan simulasi relay. Dijadwalkan setelah LED dan sensor 3 jalur ditempel pada maket dan konektor PSU diperbaiki.

# 8. Kendala dan Solusi

Kendala | Dampak | Solusi yang Dilakukan
Arus catu pada uji 5 jalur kurang kuat dan konektor power supply bermasalah | 5 jalur tidak dapat dicatu dengan baik; 20 jalur tidak dapat diuji | Pengujian disederhanakan ke 3 jalur (18 LED, 3 sensor) dan berhasil; kecerahan dibatasi 60/255; konektor PSU diperbaiki / diganti agar uji 20 jalur dapat dilakukan
Sensor api hanya tersedia untuk 3 jalur pada uji | Jalur lain tidak bisa diuji dengan api nyata | Jalur lain disimulasikan lewat perintah Serial (block / clear / reset) pada Dijkstra peta lengkap 20 jalur
Pin ESP32 terbatas (20 strip + 20 sensor) dan ADC2 tidak dapat dibaca saat ESP-NOW aktif | Pemetaan pin 20 jalur rumit; pembacaan sensor analog di ADC2 tidak andal | Uji 3 jalur memakai ADC1 (GPIO 32, 33, 34) untuk sensor dan GPIO 5, 13, 14 untuk strip; pemetaan 20 jalur didokumentasikan dengan peringatan pin boot

# 9. Deviasi Terhadap Jadwal

Aktivitas | Jadwal Awal | Realisasi | Keterangan
Penyolderan LED strip dan kabel data | 3 Oktober 2026 (Pekan 6) | Seluruh LED strip (20 jalur) selesai disolder pada Pekan 7 | Terlambat ±1 pekan
Kode prototipe penuh dan scaling 20 jalur | 10 Oktober 2026 | Selesai pada Pekan 7 | Sesuai jadwal
Integrasi dan uji penuh pada maket (20 jalur) | 10 Oktober 2026 | Uji hanya pada 3 jalur | Terhambat arus catu dan konektor PSU
Relay, DFPlayer, graf Lantai 1, pengukuran daya | 10 Oktober 2026 | Belum dikerjakan | Dijadwalkan ulang Pekan 8

### Analisis Deviasi

Kode prototipe penuh selesai sesuai jadwal dan seluruh LED sudah disolder, tetapi integrasi dan pengujian penuh tertunda karena arus catu kurang kuat dan konektor power supply bermasalah. Pekerjaan yang tidak bergantung pada PSU (kode, scaling, uji 3 jalur) dimaksimalkan pekan ini. Keterlambatan dapat dikejar pada awal Pekan 8: LED dan sensor 3 jalur langsung ditempel pada maket, sementara konektor PSU diperbaiki untuk uji 20 jalur.

# 10. Rencana Kerja Pekan Berikutnya

No | Aktivitas | PIC | Target Selesai
1 | Perbaiki / ganti konektor PSU, lalu uji 20 jalur penuh dengan power supply 5 V (cek arus dan drop tegangan) | Kemas Rasyad Subhan, Satria Pakarti Siswantra | 12 Oktober 2026
2 | Tempel LED strip dan sensor 3 jalur yang sudah berhasil pada maket Gedung K; tambah jalur bertahap setelah catu daya siap | Seluruh anggota | 14 Oktober 2026
3 | Kalibrasi ambang sensor, ukur jarak/sudut deteksi, dan ukur konsumsi daya (idle, hijau, merah) | Muhammad Arya Wiandra Utomo, Fido Wahyu Choirulinsan | 14 Oktober 2026
4 | Uji end-to-end: respons deteksi ke LED ≤ 2 detik, reroute, skenario semua exit tertutup | Seluruh anggota | 15 Oktober 2026
5 | Implementasi relay (simulasi MCB trip) dan audio DFPlayer Mini | Rasendriya Arsanta, Fido Wahyu Choirulinsan | 16 Oktober 2026
6 | Persiapan presentasi progres (slide, demo maket, data pengujian) | Rasendriya Arsanta dan seluruh anggota | 17 Oktober 2026

# 11. Persentase Progress Proyek

Komponen | Bobot (%) | Progress (%)
Perancangan | 20 | 20
Implementasi Hardware | 25 | 15
Implementasi Software | 25 | 22
Integrasi Sistem | 15 | 7
Pengujian | 10 | 4
Dokumentasi | 5 | 4

### Progress Total Proyek

Progress Total = 72 %

# 12. Kesimpulan

Pada Pekan 7, kelompok 21 menyelesaikan penyolderan seluruh LED strip dan kode prototipe penuh yang sudah di-scale ke 20 jalur (Dijkstra, sensor, ESP-NOW, LED strip per jalur). Uji 5 jalur terkendala arus catu yang kurang kuat dan konektor power supply, sehingga pengujian disederhanakan menjadi 3 jalur (18 LED, 3 sensor api); pada 3 jalur sistem berhasil berjalan dari sensor hingga LED. Prioritas Pekan 8: tempel LED strip dan sensor pada maket, ukur jarak deteksi sensor dan daya, perbaiki konektor PSU untuk uji 20 jalur, lalu siapkan presentasi progres.

# Persetujuan

Jabatan | Nama | Tanda Tangan

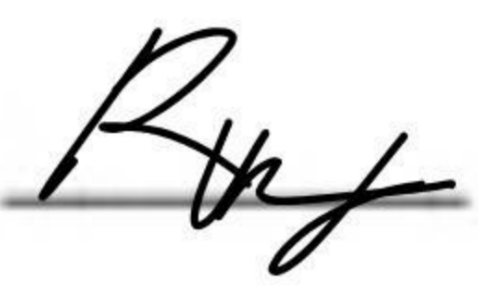
[picture p16: figure]

Ketua Kelompok | Rasendriya Arsanta
Pembimbing | Dr. Eng. Mia Rizkinia, S.T., M.T.
