aryawiandra/despro-2/Week7/PPT_SAFE-EXIT_Pekan7_Kelompok21_MBB.pptx

SAFE-EXIT

Adaptive Fire-Evacuation Path Lighting System

Laporan Kemajuan Pekan 7 | 5 – 10 Oktober 2026

Desain Proyek Grup Interdisiplin 21 | Teknik Elektro, Universitas Indonesia

Notes: Pembuka: progres Pekan 7 SAFE-EXIT. LED selesai disolder, kode prototipe penuh selesai, uji terbatas 5 jalur karena kabel PSU.

## Slide 2

Uji 3 jalur berhasil; LED dan sensor tinggal ditempel pada maket

20

jalur LED strip
selesai disolder

TERCAPAI

100%

kode prototipe penuh
dan scaling 20 jalur

TERCAPAI

3 / 3

jalur uji berhasil
(18 LED, 3 sensor api)

BERHASIL

Berikutnya: tempel di maket Gedung K; uji 20 jalur setelah konektor PSU diperbaiki.

Catatan: uji 5 jalur terkendala arus catu dan konektor power supply (PSU), sehingga uji disederhanakan ke 3 jalur.

SAFE-EXIT | Pekan 7 2

Notes: Target: solder LED (tercapai), kode prototipe + scaling (tercapai), uji penuh dengan PSU (belum).

## Slide 3

Dijkstra dihitung di sender; receiver hanya menampilkan rute ke LED

Sensor api
(AO, ADC1)

ESP32 Sender
Dijkstra 20 jalur

ESP-NOW
kirim saat berubah

ESP32 Receiver
WS2812B per jalur

Prinsip kerja

Graf

15 simpul / 20 jalur; jalur kena api dibuang, rute dihitung ulang

Sensor

Api bila ADC < 1500, aman lagi bila > 1800 (histeresis anti-kedip)

Komunikasi

ESP-NOW hemat: kirim 3x hanya saat ada perubahan; idle 2 menit = 0 paket

Catatan: pengukuran paket ESP-NOW dilakukan pada uji PC, belum pada hardware penuh.

SAFE-EXIT | Pekan 7 3

## Slide 4

Receiver menyajikan tiga status jalur lewat warna dan pola LED yang berbeda

Tampilan

Pola

Hijau + kepala terang bergerak

Arti

Jalur rute tercepat menuju exit

Merah berkedip 400 ms

Jalur terkena api (sensor atau simulasi)

Mati

Jalur aman tetapi bukan rute

Catatan: kecerahan 60/255 agar beban tetap di bawah batas USB saat uji.

SAFE-EXIT | Pekan 7 4

## Slide 5

Uji 3 jalur berhasil: 18 LED dan 3 sensor api; peta Dijkstra tetap 20 jalur

Jalur | Nama | LED | Pin strip | Pin sensor (AO)
#3 | j2-j3 | 7 | GPIO 5 (D5) | GPIO 32

#18 | j4-e2 | 6 | GPIO 13 (D13) | GPIO 33

#19 | j6-e2 | 5 | GPIO 14 (D14) | GPIO 34

Kenapa 3 jalur?

Uji 5 jalur terkendala: arus catu kurang kuat dan konektor power supply bermasalah.
3 jalur (18 LED) berhasil dari sensor hingga LED; tinggal ditempel di maket.

Catatan: 18 LED ≈ 0,24 A (perkiraan dari 0,45 A untuk 34 LED). Jalur lain disimulasikan lewat Serial.

SAFE-EXIT | Pekan 7 5

## Slide 6

Sensor api memindai 760–1100 nm pada ±60°, dibaca ADC 12 bit dengan ambang 1500 / 1800

Parameter | Spesifikasi
Spektrum / sudut deteksi | ±760–1100 nm (IR dekat) / ±60°
Jarak deteksi (tipikal) | ±20 cm (api korek) hingga ±80 cm (api besar); diatur potensiometer
Rentang scan ADC | 0–4095 (12 bit), atenuasi 11 dB ≈ 0–3,3 V; nilai turun saat ada api
Ambang deteksi | Api bila < 1500 (≈1,21 V); aman lagi bila > 1800 (≈1,45 V)
Periode scan | 50 ms (20 Hz), rata-rata 8 sampel, konfirmasi 3 scan: deteksi ±150 ms
Pin AO (ADC1) | GPIO 32, 33, 34 untuk jalur #3, #18, #19; VCC 3,3 V
Jarak deteksi terukur | [isi hasil ukur di maket: … cm]

Catatan: spesifikasi modul adalah tipikal datasheet (flame sensor LM393), bukan hasil ukur. Jarak deteksi aktual diukur di maket.

SAFE-EXIT | Pekan 7 6

## Slide 7

Kendala catu daya diatasi dengan uji 3 jalur; uji 20 jalur menunggu konektor PSU

Kendala

Arus catu 5 jalur kurang kuat; konektor PSU bermasalah

Solusi / mitigasi

Uji disederhanakan ke 3 jalur (18 LED) dan berhasil; perbaiki / ganti konektor PSU

Jalur lain disimulasikan lewat Serial pada peta penuh

Sensor api fisik hanya 3

Uji bertahap 5 > 10 > 20; level shifter / 330 Ω bila LED berkedip

Kode 20 jalur belum teruji beban penuh

Deviasi: penyolderan terlambat ±1 pekan; kode sesuai jadwal; uji 20 jalur digeser ke Pekan 8.

Catatan: deviasi = penyolderan terlambat ±1 pekan; kode sesuai jadwal; uji 20 jalur digeser ke Pekan 8.

SAFE-EXIT | Pekan 7 7

## Slide 8

Progres total 72% (naik dari 54% di Pekan 5); Pekan 8 fokus maket dan uji end-to-end

72%

progres total (Pekan 5: 54%)

Rencana Pekan 8

– Tempel strip + sensor 3 jalur di maket Gedung K
– Perbaiki konektor PSU, uji 20 jalur 5 V
– Ukur jarak deteksi, kalibrasi sensor, ukur daya
– Uji end-to-end, relay, DFPlayer, presentasi progres

SAFE-EXIT | Pekan 7 8

Sumber: estimasi tim; bobot 20/25/25/15/10/5 (dalam % dari total proyek).

Notes: Persentase progres adalah estimasi tim: bobot 20/25/25/15/10/5.
