aryawiandra/despro-2/Week7/PPT_SAFE-EXIT_Pekan7_Kelompok21.pptx

SAFE-EXIT

Adaptive Fire-Evacuation Path Lighting System

Laporan Kemajuan Pekan 7 | 5 – 10 Oktober 2026

Desain Proyek Grup Interdisiplin 21 | Teknik Elektro UI

Notes: Pembuka: progres Pekan 7 SAFE-EXIT. LED selesai disolder, kode prototipe penuh selesai, uji terbatas 5 jalur karena kabel PSU.

## Slide 2

Ringkasan Pekan 7

Hardware LED dan software prototipe selesai; pengujian terbatas kabel PSU

20

jalur LED strip
selesai disolder

100%

kode prototipe penuh
dan scaling 20 jalur

5 / 20

jalur teruji
(kabel PSU bermasalah)

Target 2 dari 3 tercapai. Integrasi 20 jalur dengan power supply 5 V tertunda; dikejar awal Pekan 8.

Notes: Target: solder LED (tercapai), kode prototipe + scaling (tercapai), uji penuh dengan PSU (belum).

## Slide 3

Arsitektur sistem

Dijkstra jalan di sender; receiver hanya menampilkan rute

Sensor api
(AO, ADC1)

ESP32 Sender
Dijkstra 20 jalur

ESP-NOW
kirim saat berubah

ESP32 Receiver
WS2812B per jalur

- Graf 15 simpul / 20 jalur; jalur kena api dibuang, rute dihitung ulang
- Sensor: api bila ADC < 1500, aman lagi bila > 1800 (histeresis anti-kedip)
- ESP-NOW hemat: kirim 3x hanya saat ada perubahan; idle 2 menit = 0 paket (uji PC)

## Slide 4

Tampilan LED di receiver

Satu strip per jalur, satu pin data per jalur

Hijau + kepala terang bergerak

Jalur rute tercepat menuju exit

Merah berkedip 400 ms

Jalur terkena api (sensor atau simulasi)

Kecerahan 60/255 agar beban tetap di bawah batas USB saat uji.

Mati

Jalur aman tetapi bukan rute

## Slide 5

Uji 5 jalur

Peta Dijkstra tetap 20 jalur; strip dan sensor fisik hanya 5

Jalur | Nama | LED | Pin strip | Pin sensor (AO)
#3 | j2-j3 | 7 | GPIO 4 | GPIO 32

#11 | j7-j9 | 8 | GPIO 5 | GPIO 33

#15 | j10-j12 | 8 | GPIO 13 | GPIO 34

#18 | j4-e2 | 6 | GPIO 14 | GPIO 35

#19 | j6-e2 | 5 | GPIO 18 | GPIO 36

Kenapa 5 jalur?
Kabel PSU belum bisa dipakai, jadi power supply 5 V tidak bisa dipakai. 34 LED cukup dari USB laptop (perkiraan ±0,45 A).

Jalur lain disimulasikan lewat Serial: block j6-j7, clear, reset.

## Slide 6

Kendala, solusi, dan deviasi

Uji dialihkan ke 5 jalur via USB; perbaiki / ganti kabel PSU

Kabel PSU tidak bisa dipakai

Jalur lain disimulasikan lewat Serial pada peta penuh

Sensor api fisik hanya 5

Uji bertahap 5 > 10 > 20; level shifter / 330 Ω bila LED berkedip

Deviasi: penyolderan terlambat ±1 pekan; kode sesuai jadwal; uji penuh digeser ke Pekan 8.

Kode 20 jalur belum teruji beban penuh

## Slide 7

Progress dan rencana Pekan 8

72%

progress total (Pekan 5: 54%)

- Ganti / perbaiki kabel PSU, uji 20 jalur 5 V
- Pasang strip + sensor di maket Gedung K
- Kalibrasi sensor, ukur daya, uji end-to-end
- Relay, DFPlayer, presentasi progres

Notes: Persentase progres adalah estimasi tim: bobot 20/25/25/15/10/5.
