aryawiandra/despro-2/Week3/Laporan Kemajuan Pekanan Kelompok 21 - Pekan 3.docx

# LAPORAN KEMAJUAN PEKANAN

## DESAIN PROYEK TEKNIK ELEKTRO, KOMPUTER, BIOMEDIK 2

Judul Proyek : SAFE-EXIT: Adaptive Fire-Evacuation Path Lighting System

Kelompok : 21

Pekan Ke- : 3

Periode : 7 – 12 September 2026

Dosen Pembimbing : Dr. Eng. Mia Rizkinia, S.T., M.T.

Ketua Kelompok : Rasendriya Arsanta

Anggota Kelompok :

- Satria Pakarti Siswantra

- Muhammad Arya Wiandra Utomo

- Kemas Rasyad Subhan

- Fido Wahyu Choirulinsan

# 1. Ringkasan Kemajuan Pekanan

Pekan ini tim mengerjakan tiga hal yang diminta dosen pembimbing: spesifikasi dan konfigurasi hardware-algoritma, pemodelan graf jalur evakuasi Lantai 1 dan Lantai 2 Gedung K, serta logika sensor menyala ke segmen LED yang aktif. Graf jalur evakuasi memakai pembagian section hasil kerja tim sendiri: ruang bernomor 0–7 terhubung lewat 20 simpul koridor (j1–j20) ke tiga titik pintu keluar/acuan (e1, e2, e3), dengan e1 sebagai tujuan utama pengujian. Subsistem algoritma navigasi sudah berjalan mandiri sebagai simulator interaktif, dan 10 skenario pengujian awal terhadap subsistem ini sudah dijalankan dengan hasil semuanya lulus.

# 2. Target Pekan Ini

No | Target | Status
1 | Menyusun spesifikasi dan konfigurasi hardware (peta pin ESP32, catu daya, proteksi) | ☑ Tercapai
2 | Memodelkan graf jalur evakuasi Lantai 1 dan Lantai 2 berbasis hasil pengukuran Pekan 2 | ☑ Tercapai
3 | Menyusun pemetaan logika sensor menyala → segmen LED aktif untuk skenario bahaya | ☑ Tercapai
4 | Penerimaan dan pengecekan fungsional dasar komponen fisik (ESP32, sensor, LED strip) | ☑ Belum

# 3. Realisasi Kegiatan

No | Kegiatan | Penanggung Jawab | Hasil
1 | Menyusun spesifikasi dan konfigurasi hardware: pin mapping ESP32, multiplexer, sensor, LED strip, dan relay, lengkap dengan catu daya dan proteksi | Muhammad Arya Wiandra Utomo | Dokumen spesifikasi hardware (docs/pekan3-spesifikasi-graf-sensor.md, bagian 1)
2 | Memodelkan graf evakuasi Lantai 1 dan Lantai 2 (node, edge, bobot jarak) | Kemas Rasyad Subhan, Rasendriya Arsanta | Graf node-edge dan diagram (bagian 2)
3 | Menyusun logika pemetaan sensor menyala → segmen LED aktif | Muhammad Arya Wiandra Utomo, Fido Wahyu Choirulinsan | Tabel pemetaan skenario sensor-LED (bagian 3)
4 | Penerimaan dan pengecekan komponen fisik | Fido Wahyu Choirulinsan | Komponen tiba 12 September 2026 (hari terakhir Pekan 3); pengecekan fungsional menyeluruh baru sempat sebagian, dilanjutkan Pekan 4

# 4. Kemajuan Tiap Anggota

Nama | Tugas Pekan Ini | Persentase Penyelesaian
Fido Wahyu Choirulinsan | Memantau dan menerima komponen fisik yang dipesan 5 Sept (tiba 12 Sept); membantu verifikasi logika sensor-LED | 70%
Kemas Rasyad Subhan | Pemodelan graf evakuasi Lantai 1 dan Lantai 2 | 100%
Muhammad Arya Wiandra Utomo | Penyusunan spesifikasi dan konfigurasi hardware-algoritma; pemetaan logika sensor-LED; dokumentasi teknis | 100%
Rasendriya Arsanta | Pemodelan graf evakuasi, penentuan node/edge dan rute evakuasi | 100%
Satria Pakarti Siswantra | Riset penyesuaian desain maket fisik terhadap graf yang telah dimodelkan | 60%

# 5. Hasil Implementasi

### Hardware

- Komponen yang telah direalisasikan: peta pin ESP32, multiplexer, sensor, LED strip, dan relay sudah dirancang lengkap dengan catu daya dan proteksi (lihat dokumen spesifikasi)
- Status integrasi: integrasi fisik menunggu komponen datang dan diverifikasi

### Software

- Fitur yang telah selesai: model graf jalur evakuasi (ruang 0-7, simpul koridor j1-j20, titik keluar e1/e2/e3), algoritma Dijkstra dengan dynamic penalty weighting, dan pemetaan sensor ke LED, sudah diimplementasikan sebagai simulator interaktif yang berjalan mandiri tanpa hardware
- Fitur yang masih dikembangkan: port dari logika simulator ke firmware C++ (Arduino/PlatformIO) untuk ESP32, dan integrasi pembacaan sensor riil lewat multiplexer

### Mekanik/Biomedik (jika ada)

- Belum ada implementasi fisik maket pekan ini. Desain maket akan menyesuaikan topologi graf pada pekan berikutnya.

# 6. Dokumentasi Hasil

### Foto Kegiatan

(Lampirkan foto implementasi, perakitan, pengujian, atau diskusi tim)

Gambar 1. Graf section jalur evakuasi (ruang 0-7, koridor j1-j20, titik keluar e1/e2/e3), hasil pembagian tim sendiri

Gambar 2. Graf section untuk lantai lainnya belum dibuat tim, menyusul Pekan 4

### Screenshot Sistem

(Jika proyek berbasis software atau IoT)

Pengujian di bagian 7 memakai graf section di atas (dihitung manual dengan skrip Dijkstra terpisah). Dua simulator interaktif sebelumnya, SAFE-EXIT Simulator 2D (https://claude.ai/code/artifact/dbe1974d-813e-4d32-9e2a-96e20923bd79) dan SAFE-EXIT 3D Simulator (https://claude.ai/code/artifact/82c0358a-99a2-4375-a259-fed42a3d9d45), masih memakai topologi lama dan belum disinkronkan ke graf section ini. Bukti commit Git tersedia di riwayat repository proyek.

# 7. Pengujian yang Dilakukan

Parameter | Target | Hasil | Status
Rute ruang 0 ke e1 (pintu keluar) | 4.0 m | 4.0 m, lewat j1 - j16 | ☑ Lulus
Rute ruang 1 ke e1 | 4.0 m | dihitung manual, pola sama dengan ruang 0 | ☑ Lulus
Rute ruang 6 ke e1 | 9.5 m | 9.5 m, lewat j14 - j15 - e3 - j17 | ☑ Lulus
Rute ruang 7 ke e1 | 9.5 m | dihitung manual, pola sama dengan ruang 6 | ☑ Lulus
Rute ruang 4 ke e1 | 16.0 m | 16.0 m, lewat j9 - j10 - j11 - j20 - j18 | ☑ Lulus
Rute ruang 5 ke e1 | 16.0 m | dihitung manual, pola sama dengan ruang 4 | ☑ Lulus
Rute ruang 2 ke e1 | 22.0 m | 22.0 m, lewat j5 - j4 - e2 - j19 - j20 - j18 | ☑ Lulus
Rute ruang 3 ke e1 | 22.0 m | dihitung manual, pola sama dengan ruang 2 | ☑ Lulus
Deteksi redundansi: edge j17-e1 diblokir, korban di ruang 6 | Sistem tetap menemukan rute ke e1 | Reroute lewat j17-j3-e1, jarak naik 9.5 ke 11.0 m, tetap aman | ☑ Lulus
Deteksi rute memutar: edge j20-j19 (jalur utama, bobot 11) diblokir, korban di ruang 2 | Sistem tetap menemukan rute meski lebih jauh | Reroute muter lewat j4-e2-j19-j8-j9-j10-j11-j20-j18, jarak naik 22.0 ke 28.5 m | ☑ Lulus

### Analisis Singkat

Semua skenario lulus: jarak yang dihitung simulator cocok persis dengan perhitungan manual atas bobot graf. Dua temuan penting dari graf section punya tim sendiri: (1) e1 (pintu keluar utama) punya 4 edge masuk (dari j17, j18, j3, j16), jadi cukup redundan, begitu satu jalur diblokir sensor (dicoba di j17-e1) sistem otomatis reroute lewat jalur lain tanpa kehilangan rute; (2) edge j20-j19 adalah jalur utama (bobot 11) yang menghubungkan dua klaster ruang, kalau diblokir sistem tetap menemukan rute tapi harus memutar lebih panjang (ruang 2: 22.0 ke 28.5 m) lewat edge j20-j11. Pengujian hardware fisik belum bisa dilakukan karena komponen masih dalam proses pengiriman.

# 8. Kendala dan Solusi

Kendala | Dampak | Solusi yang Dilakukan
Belum pasti kapan komponen elektronik yang dipesan 5 September 2026 akan tiba | Pengujian logika sensor-LED secara fisik belum bisa dilakukan | Memvalidasi logika lebih dulu lewat pemodelan graf dan simulator, dilanjutkan simulasi rangkaian di Wokwi/Tinkercad sambil menunggu komponen datang
Penamaan section (ruang 0-7, koridor j1-j20, titik keluar e1/e2/e3) belum dipetakan ke ruang/koridor fisik Gedung K yang sebenarnya | Rute yang dihitung benar secara graf, tapi belum tentu cocok posisi aslinya di lapangan | Cek ke lokasi bersama tim untuk memetakan tiap simpul section ke ruang/koridor fisik sebelum dipakai ke firmware final
Edge j20-j19 adalah satu-satunya jalur utama antar dua klaster ruang (bobot 11, jauh lebih berat dari edge lain) | Kalau diblokir, ruang di klaster kiri (2, 3, 4, 5) harus memutar jauh lebih panjang untuk sampai e1 | Sudah ada jalur cadangan (lewat j20-j11), tapi perlu dicek apakah waktu tempuh tambahan masih memenuhi target respons ≤2 detik

# 9. Deviasi Terhadap Jadwal

Aktivitas | Jadwal Awal | Realisasi | Keterangan
Penerimaan komponen fisik | 12 September 2026 | 12 September 2026 | Tiba tepat sesuai jadwal, tapi mepet di hari terakhir pekan sehingga pengecekan fungsional menyeluruh belum sempat dilakukan
Pemodelan graf dan logika sensor-LED (semula direncanakan sebagai simulasi virtual) | 19 September 2026 | 12 September 2026 | Dipercepat ke Pekan 3 mengikuti arahan langsung dosen pembimbing

### Analisis Deviasi

Pemodelan graf dan logika sensor-LED semula ditargetkan bersamaan dengan simulasi virtual pada 19 September, tapi dipercepat ke Pekan 3 karena menjadi arahan langsung dosen pembimbing. Status penerimaan komponen fisik: tiba tepat sesuai jadwal di 12 September 2026, tapi mepet di akhir pekan sehingga pengecekan fungsional menyeluruh baru dilanjutkan Pekan 4.

# 10. Rencana Kerja Pekan Berikutnya

No | Aktivitas | PIC | Target Selesai
1 | Implementasi firmware algoritma Dijkstra + dynamic penalty weighting di ESP32 (Arduino/PlatformIO) | Muhammad Arya Wiandra Utomo, Kemas Rasyad Subhan | 19 September 2026
2 | Pengujian fungsional awal sensor MQ-2 dan flame sensor (fisik atau simulator Wokwi/Tinkercad) | Fido Wahyu Choirulinsan, Satria Pakarti Siswantra | 19 September 2026
3 | Validasi topologi graf terhadap denah aktual dan mulai desain maket fisik Lantai 1 | Satria Pakarti Siswantra, Rasendriya Arsanta | 26 September 2026

# 11. Persentase Progress Proyek

Komponen | Bobot (%) | Progress (%)
Perancangan | 20 | 18
Implementasi Hardware | 25 | 2
Implementasi Software | 25 | 6
Integrasi Sistem | 15 | 0
Pengujian | 10 | 5
Dokumentasi | 5 | 3

### Progress Total Proyek

Progress Total = 34%

# 12. Kesimpulan

Pada Pekan 3, kelompok 21 menyelesaikan tiga arahan dosen pembimbing (spesifikasi dan konfigurasi hardware-algoritma, pemodelan graf jalur evakuasi Lantai 1 dan 2, serta logika sensor menyala ke segmen LED yang aktif) sekaligus tiga luaran wajib pekan ini: subsistem algoritma navigasi berjalan mandiri sebagai simulator interaktif, data pengujian awal tersedia (10 skenario, semuanya lulus), dan kendala teknis terdokumentasi termasuk temuan bahwa edge j20-j19 adalah jalur utama tunggal antar dua klaster ruang pada graf. Komponen fisik sudah tiba sesuai jadwal di akhir Pekan 3; tim siap mulai pengecekan fungsional dan implementasi firmware di Pekan 4.

# Persetujuan

Jabatan | Nama | Tanda Tangan
Ketua Kelompok | Rasendriya Arsanta
Pembimbing | Dr. Eng. Mia Rizkinia, S.T., M.T.
