aryawiandra/despro-2/Week3/Laporan Pekanan Individu - Arya - Pekan 3.docx

# TEMPLATE LAPORAN PEKANAN INDIVIDU

## Capstone Project Desain Proyek 2

### A. Identitas Mahasiswa

Item | Keterangan
Nama | Muhammad Arya Wiandra Utomo
NPM | 2306218295
Program Studi | Teknik Komputer
Kelompok | 21
Judul Proyek | SAFE-EXIT: Adaptive Fire-Evacuation Path Lighting System
Pekan ke- | 3
Periode Tanggal | 7 – 12 September 2026
Dosen Pembimbing | Dr. Eng. Mia Rizkinia, S.T., M.T.

## B. Target Mingguan

Target yang direncanakan pada awal pekan berdasarkan WBS dan pembagian tugas kelompok.

No | Target Pekerjaan | Luaran yang Diharapkan | Status
1 | Penerimaan, inventarisasi, dan pengujian fungsional komponen testing (sanity check hardware) | Seluruh komponen testing terverifikasi berfungsi normal | ☑ Belum
2 | Perancangan skema rangkaian dasar dan spesifikasi integrasi sensor (MQ-2 dan Flame Sensor) ke ESP32 | Peta pin/skematik rangkaian dan pseudocode pembacaan data sensor | ☑ Selesai
3 | Pemodelan graf jalur evakuasi (denah) sebagai dasar desain maket fisik | Model graf (node/edge) jalur evakuasi Lantai 1 dan 2 | ☑ Selesai

## C. Logbook Aktivitas Harian

Hari/Tanggal | Uraian Aktivitas | Waktu (Jam) | Bukti/Dokumen
Senin | Rapat tim awal pekan, breakdown tugas Pekan 3 sesuai arahan dosen pembimbing (spesifikasi hardware, graf, logika sensor-lampu) | 2 | Notulensi rapat
Selasa | Menyusun peta pin ESP32 dan konfigurasi catu daya/proteksi | 3 | Draft dokumen spesifikasi hardware
Rabu | Memodelkan graf jalur evakuasi Lantai 1 dan 2 bersama Kemas Rasyad Subhan dan Rasendriya Arsanta | 3 | Sketsa graf dan diagram
Kamis | Menyusun logika pemetaan sensor ke LED, mulai membangun simulator 2D | 3 | Draft simulator interaktif
Jumat | Menyelesaikan simulator 3D, menjalankan skenario pengujian awal | 3 | Hasil pengujian di simulator
Sabtu | Menyusun spesifikasi dan konfigurasi hardware-algoritma, memodelkan graf evakuasi Lantai 1 dan 2, menyusun logika sensor ke LED, dan membangun simulator interaktif untuk pengujian awal. Hasilnya didokumentasikan di repository. | 2 | docs/pekan3-spesifikasi-graf-sensor.md, diagram graf, simulator 3D

### Total Jam Kerja Minggu Ini : 16 Jam

## D. Realisasi Pekerjaan

### 1. Aktivitas yang Berhasil Diselesaikan

- ] Menyusun spesifikasi dan konfigurasi hardware-algoritma (peta pin ESP32, multiplexer, sensor, LED, relay, catu daya-proteksi) serta memodelkan graf jalur evakuasi Lantai 1 dan 2.
- ] Menyusun logika pemetaan sensor menyala ke LED untuk 5 skenario bahaya, dan membangun simulator interaktif (2D dan 3D) supaya subsistem algoritma bisa berjalan mandiri tanpa hardware.
- ] Menjalankan 10 skenario pengujian awal di simulator dan mendokumentasikan seluruh hasil teknis di repository proyek.

### 2. Luaran yang Dihasilkan

- Dokumen spesifikasi hardware dan algoritma (peta pin, catu daya, proteksi)
- Model graf evakuasi Lantai 1 dan 2 (node, edge, bobot jarak) beserta diagram
- Tabel pemetaan sensor ke LED untuk 5 skenario bahaya
- Pseudocode algoritma Dijkstra dengan dynamic penalty weighting
- Simulator interaktif (2D dan 3D) sebagai bukti subsistem algoritma berjalan mandiri
- Data hasil pengujian awal: 10 skenario, semuanya sesuai perhitungan manual

## E. Capaian Teknis Mingguan

### Komponen/Subsistem yang Dikerjakan (pilih sesuai tugas)

Subsistem | Target | Realisasi | Persentase
Hardware | Spesifikasi dan konfigurasi pin/rangkaian | Peta pin ESP32, multiplexer, sensor, LED, relay, dan catu daya sudah dirancang; perakitan fisik menunggu komponen | 30%
Software | Pemodelan graf dan algoritma evakuasi | Model graf Lantai 1 dan 2 serta algoritma Dijkstra sudah jadi simulator yang bisa dijalankan; port ke firmware ESP32 menyusul | 55%
Mekanik | – | Belum dimulai, menunggu validasi topologi graf | 0%
Pengujian | Pengujian awal subsistem algoritma | 10 skenario dijalankan di simulator, semuanya sesuai perhitungan manual; pengujian hardware fisik menyusul | 35%
Dokumentasi | Dokumentasi teknis Pekan 3 | Dokumen spesifikasi dan laporan pekanan sudah selesai | 100%

### Ringkasan Kemajuan

Pekan ini kerjaan saya lebih ke perancangan: menyusun spesifikasi dan konfigurasi hardware-algoritma, memodelkan graf jalur evakuasi Lantai 1 dan 2, dan menyusun logika sensor ke LED, sesuai arahan dosen pembimbing untuk Pekan 3. Supaya subsistem ini tidak cuma jadi dokumen, saya bangun jadi simulator yang benar-benar bisa dijalankan, lalu diuji dengan 10 skenario. Hasil ini yang akan dipakai tim untuk mulai menulis firmware dan merakit hardware pada Pekan 4.

## F. Permasalahan dan Kendala

No | Kendala | Dampak | Tingkat Risiko
1 | Pemetaan node graf ke denah aktual Gedung K masih berupa asumsi awal, belum dicek ulang ke lokasi | Topologi graf berpotensi perlu direvisi sebelum diimplementasikan ke firmware final | Sedang
2 | Temuan dari pengujian graf section (ruang 0-7, koridor j1-j20, e1/e2/e3): edge j20-j19 adalah satu-satunya jalur utama yang menghubungkan dua klaster ruang, bobotnya paling berat (11) dibanding edge lain | Kalau edge itu terblokir, ruang di klaster kiri (2, 3, 4, 5) harus memutar jauh lebih panjang untuk sampai e1 | Sedang
3 | Komponen elektronik yang dipesan 5 September 2026 baru tiba hari ini (12 September), mepet di akhir pekan | Sanity-check hardware yang direncanakan minggu ini mundur ke awal Pekan 4 | Sedang

### Graf disusun dari hasil pengukuran denah Pekan 2, tapi belum semua anggota tim mengecek ulang ke lokasi, jadi masih berupa model awal yang perlu divalidasi sebelum difinalkan.

Jelaskan penyebab utama munculnya kendala.

## G. Tindakan Korektif dan Solusi

Kendala | Solusi/Tindak Lanjut | PIC | Target Penyelesaian
Topologi graf belum tervalidasi terhadap denah aktual | Mengecek ulang ke lokasi bersama tim dan menyesuaikan node/edge graf sebelum implementasi firmware | Kelompok | 19 September 2026
Edge j20-j19 jadi jalur utama tunggal antar dua klaster ruang di graf section | Cek apakah waktu tempuh tambahan saat reroute (lewat j20-j11) masih memenuhi target respons; pertimbangkan edge tambahan kalau tidak | Kelompok | 19 September 2026

## H. Dokumentasi Kemajuan

Lampirkan:

- Dokumen spesifikasi hardware dan graf (docs/pekan3-spesifikasi-graf-sensor.md)
- Diagram graf evakuasi Lantai 1 dan Lantai 2 (docs/img/)
- Simulator interaktif 2D: https://claude.ai/code/artifact/dbe1974d-813e-4d32-9e2a-96e20923bd79
- Simulator interaktif 3D: https://claude.ai/code/artifact/82c0358a-99a2-4375-a259-fed42a3d9d45
- Data hasil pengujian awal, 10 skenario
- Commit repository: pembaruan docs/pekan3-spesifikasi-graf-sensor.md dan berkas simulator

Minimal 2-3 dokumentasi setiap pekan.

## I. Kontribusi Terhadap Tim

### Koordinasi yang Dilakukan

- Rapat tim tanggal: 7 September 2026
- Diskusi teknis: menyusun graf evakuasi dan spesifikasi hardware bersama Kemas Rasyad Subhan dan Rasendriya Arsanta
- Koordinasi dengan dosen: menindaklanjuti arahan Pekan 3 soal spesifikasi hardware, graf, dan logika sensor-lampu

### Kontribusi Pribadi

Menyusun spesifikasi dan konfigurasi hardware-algoritma serta logika sensor ke LED, ikut memodelkan graf jalur evakuasi bareng anggota tim lain, dan mendokumentasikan semua hasil teknis pekan ini ke repository proyek.

## J. Evaluasi Diri

### Yang Berjalan Baik

- Tiga arahan dosen pembimbing untuk Pekan 3 (spesifikasi hardware, graf, logika sensor-lampu) selesai tepat waktu
- Dokumentasi teknis rapi dan langsung bisa dipakai sebagai acuan implementasi firmware
- Kerja sama dengan anggota tim lain dalam pemodelan graf berjalan lancar

### Yang Perlu Diperbaiki

- Belum sempat mengecek langsung ke lokasi untuk validasi topologi graf terhadap denah fisik
- Belum menghitung buffer waktu kalau komponen datang mepet di akhir pekan seperti minggu ini

### Pelajaran yang Didapat Minggu Ini

- Graf sebaiknya divalidasi langsung ke denah fisik sebelum masuk ke firmware
- Spesifikasi hardware yang detail dari awal mempermudah transisi ke tahap implementasi
- Perlu buffer waktu ekstra kalau progres bergantung pada pengiriman komponen dari luar

## K. Rencana Pekan Berikutnya

No | Rencana Kegiatan | Target Luaran | Estimasi Jam
1 | Implementasi firmware algoritma Dijkstra + dynamic penalty weighting di ESP32 | Kode pembacaan graf dan rute berjalan di simulator/hardware | 5 Jam
2 | Pengujian awal pembacaan sensor MQ-2 dan flame sensor (fisik/simulator) | Data sensor terbaca akurat | 3 Jam
3 | Validasi topologi graf terhadap denah aktual bersama tim | Graf final terkonfirmasi | 2 Jam

## L. Persetujuan

Mahasiswa

Nama: Muhammad Arya Wiandra Utomo

Tanda tangan: ____________

Tanggal: 12 September 2026

Ketua Kelompok

Nama: Rasendriya Arsanta

Tanda tangan: ____________

Tanggal: 12 September 2026

Catatan Pembimbing
