aryawiandra/despro-2/brag-output/brag.jpg

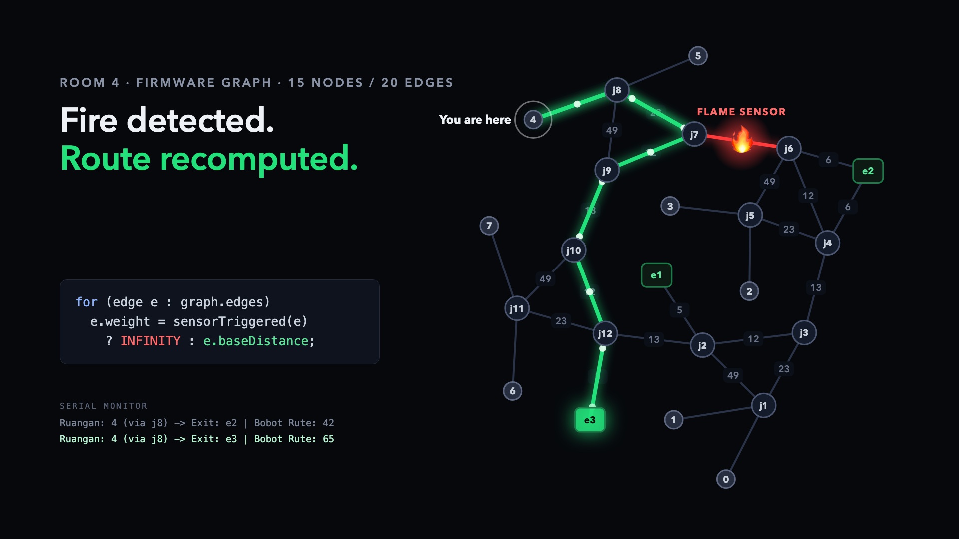
brag-output/brag.jpg
