aryawiandra/despro-2/brag-output/work/final-check.jpg

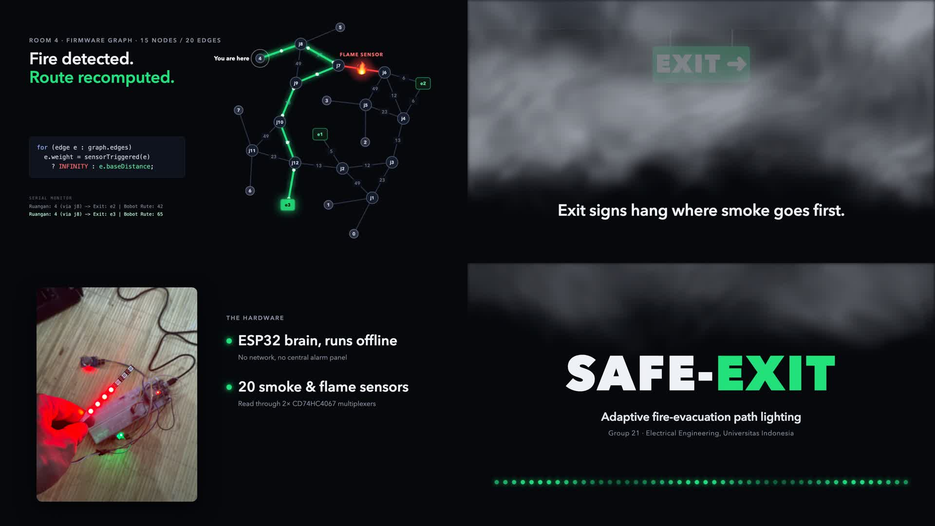
brag-output/work/final-check.jpg
