aryawiandra/despro-2/brag-output/work/frame0-original.jpg

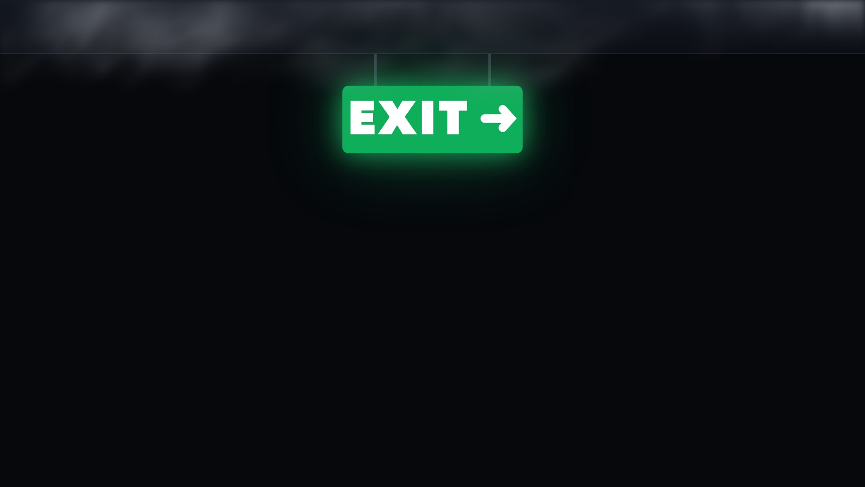
brag-output/work/frame0-original.jpg
