aryawiandra/despro-2/brag-output/work/spec.png

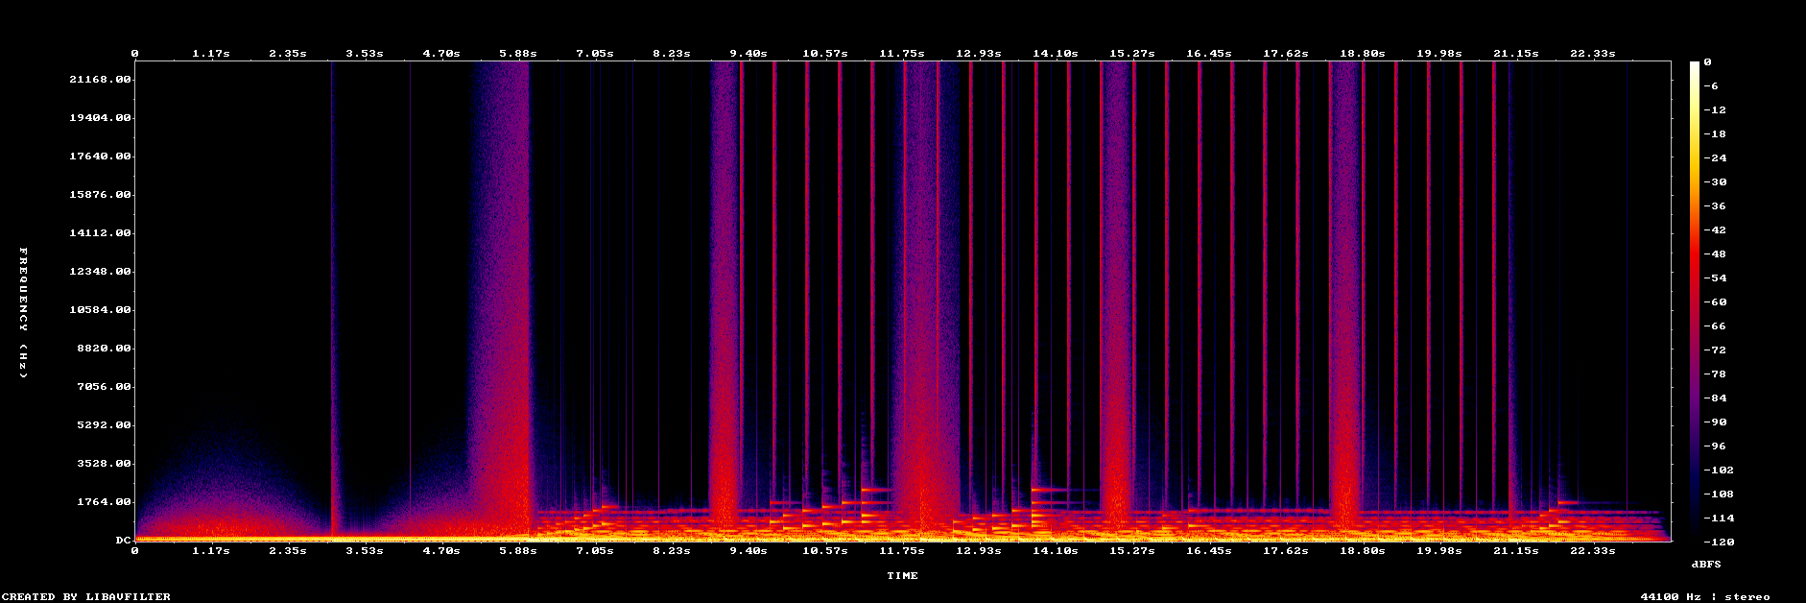
brag-output/work/spec.png
