aryawiandra/despro-2/brag-output/work/stills/sheetA.jpg

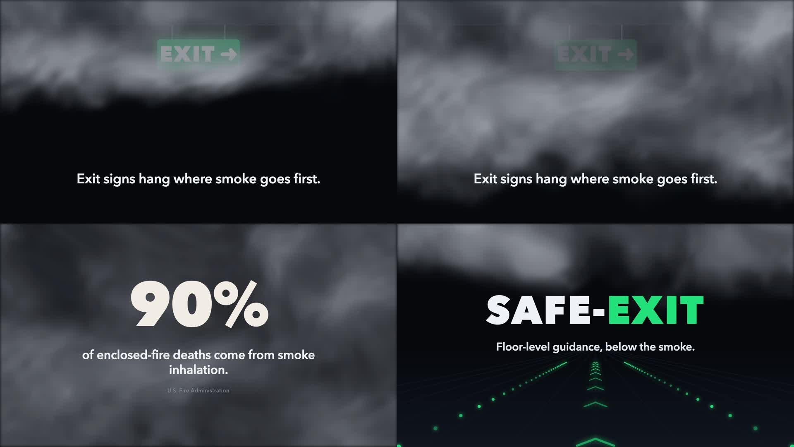
brag-output/work/stills/sheetA.jpg
