aryawiandra/despro-2/brag-output/work/stills/sheetB.jpg

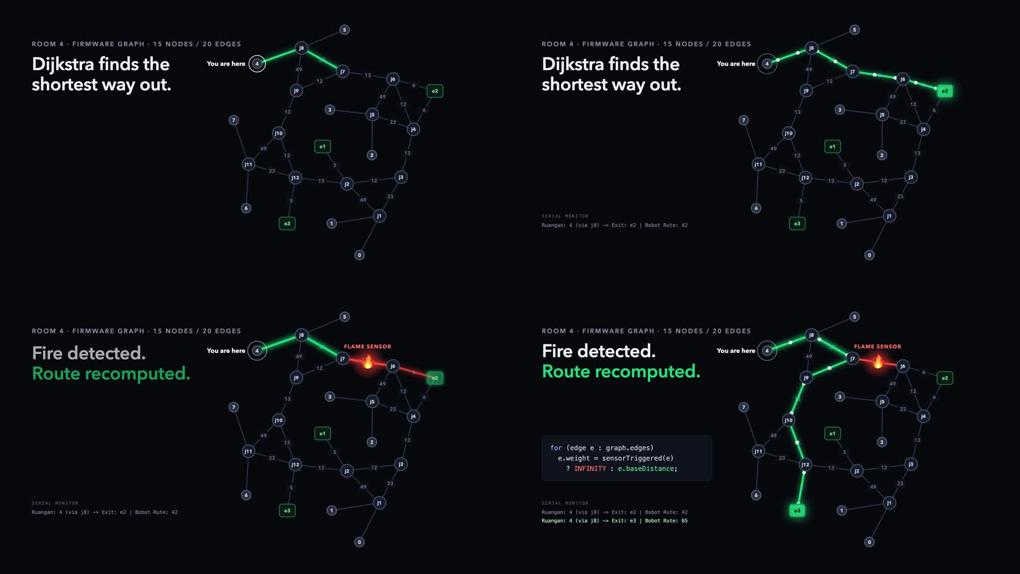
brag-output/work/stills/sheetB.jpg
