aryawiandra/despro-2/brag-output/work/stills/sheetC.jpg

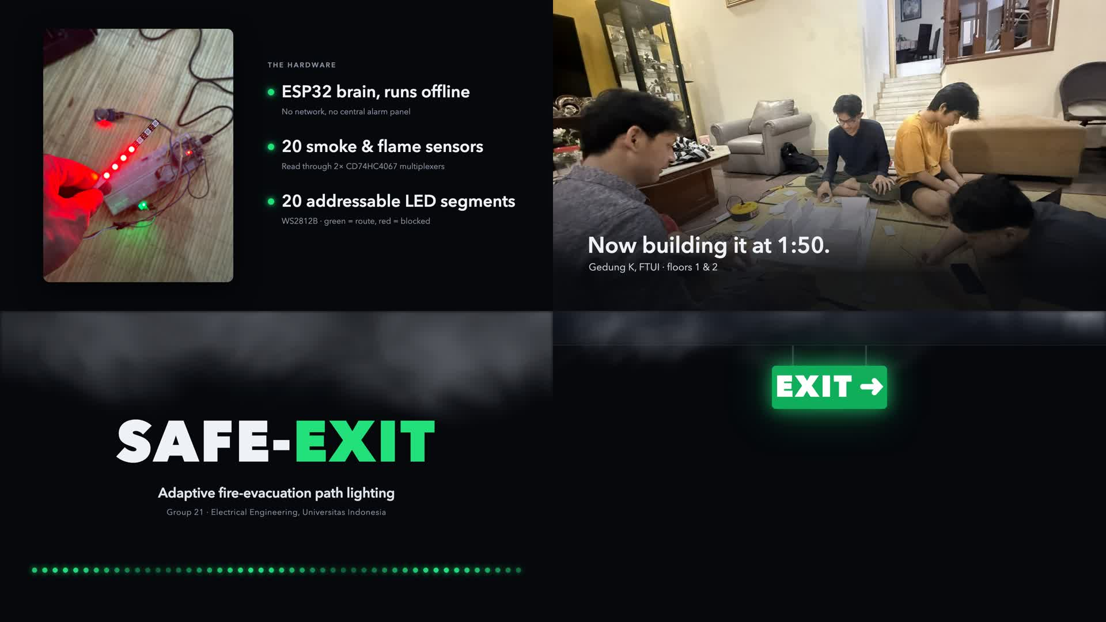
brag-output/work/stills/sheetC.jpg
