aryawiandra/despro-2/brag-output/work/stills/sheetD.jpg

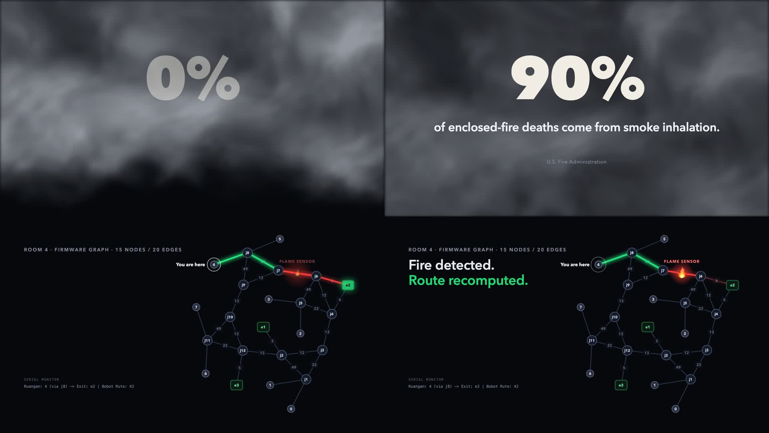
brag-output/work/stills/sheetD.jpg
