aryawiandra/despro-2/brag-output/work/stills/t1.5.jpg

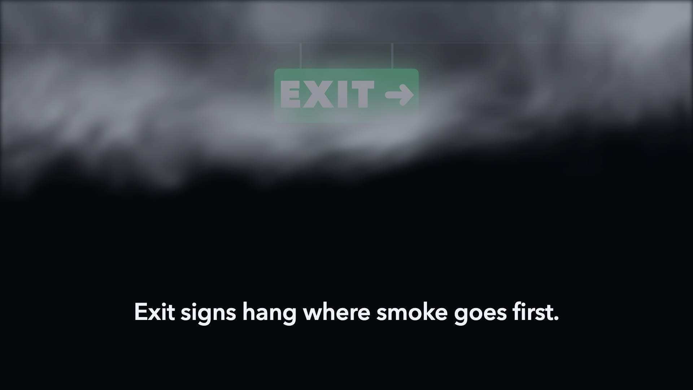
brag-output/work/stills/t1.5.jpg
