aryawiandra/despro-2/brag-output/work/stills/t2.5.jpg

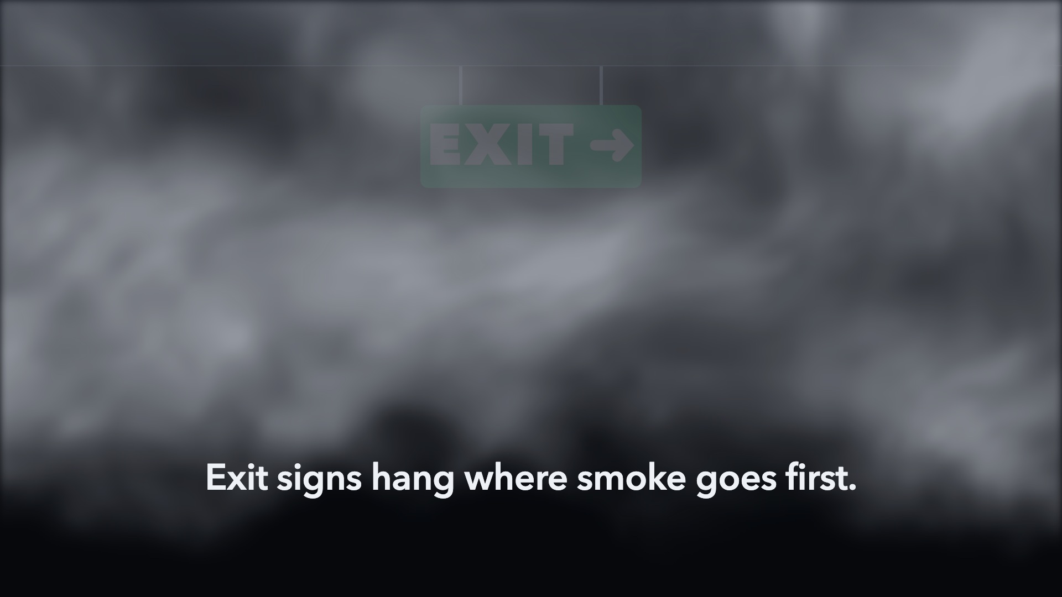
brag-output/work/stills/t2.5.jpg
