aryawiandra/despro-2/brag-output/work/stills/t3.05.jpg

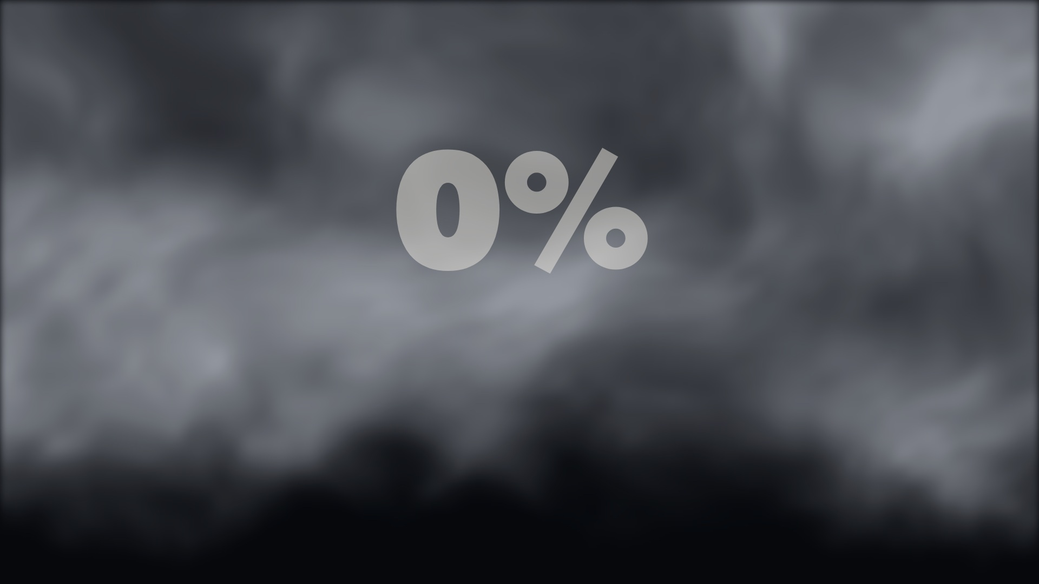
brag-output/work/stills/t3.05.jpg
