aryawiandra/despro-2/brag-output/work/stills/t4.5.jpg

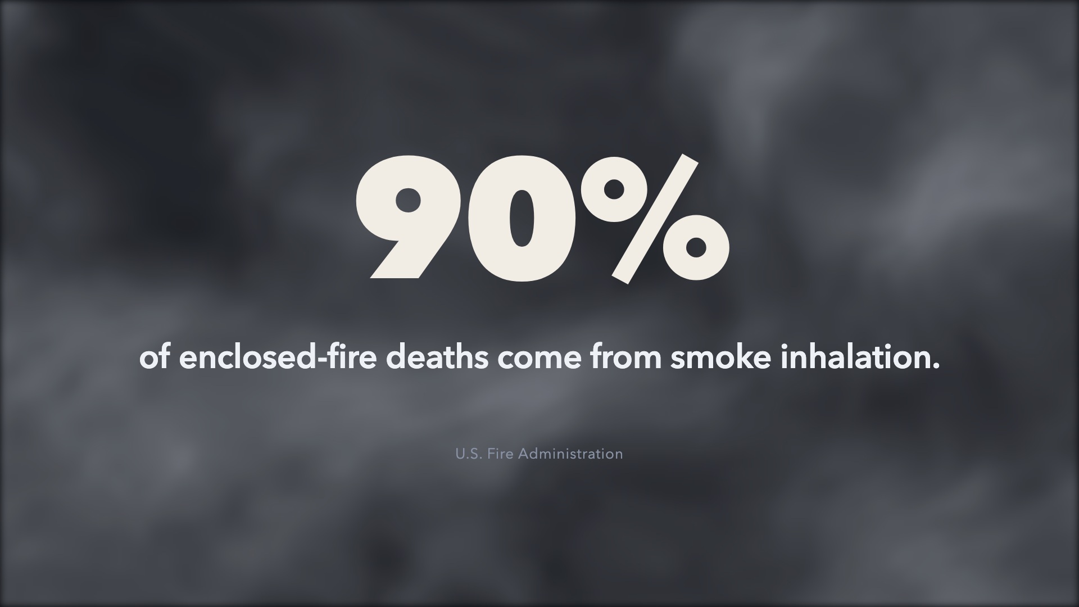
brag-output/work/stills/t4.5.jpg
