aryawiandra/despro-2/brag-output/work/stills/t7.8.jpg

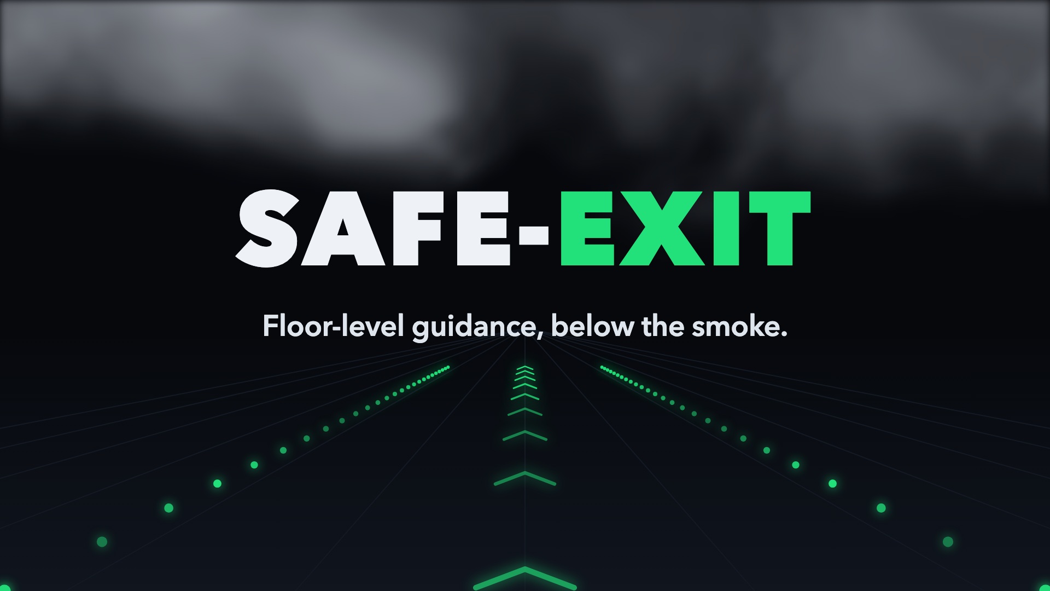
brag-output/work/stills/t7.8.jpg
