aryawiandra/despro-2/brag-output/work/stills/t10.5.jpg

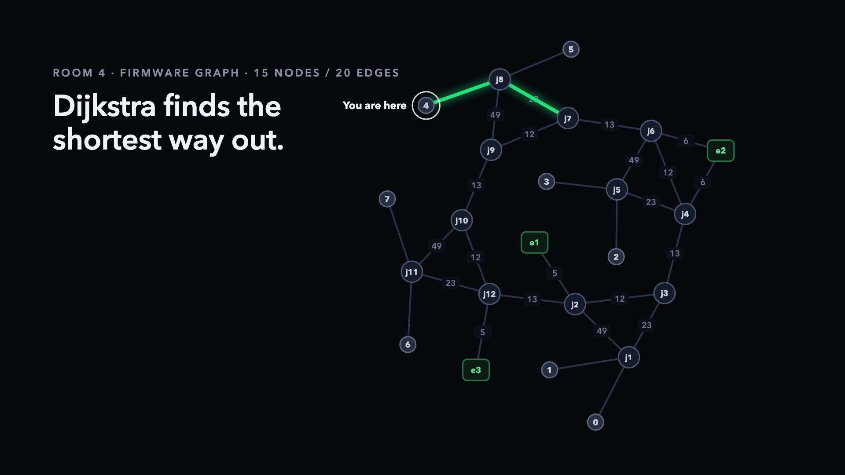
brag-output/work/stills/t10.5.jpg
