aryawiandra/despro-2/brag-output/work/stills/t11.6.jpg

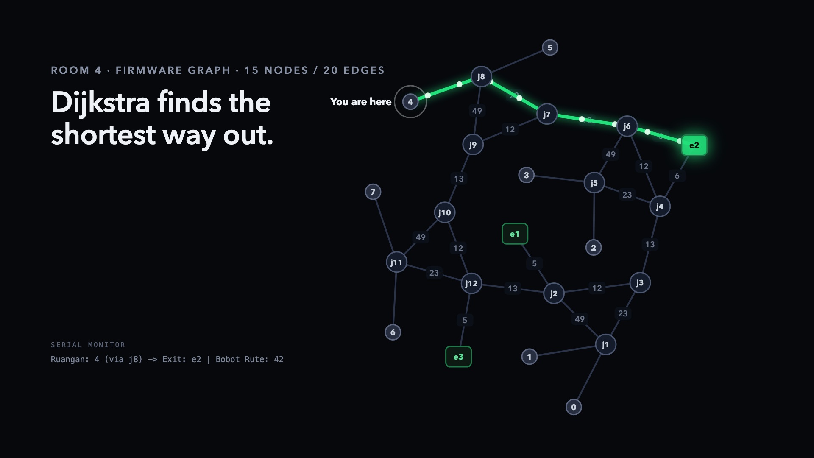
brag-output/work/stills/t11.6.jpg
