aryawiandra/despro-2/brag-output/work/stills/t12.3.jpg

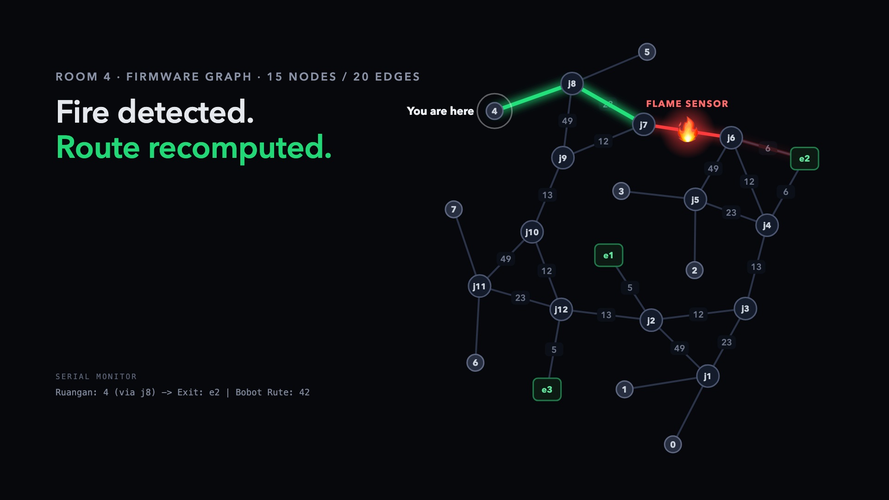
brag-output/work/stills/t12.3.jpg
