aryawiandra/despro-2/brag-output/work/stills/t12.05.jpg

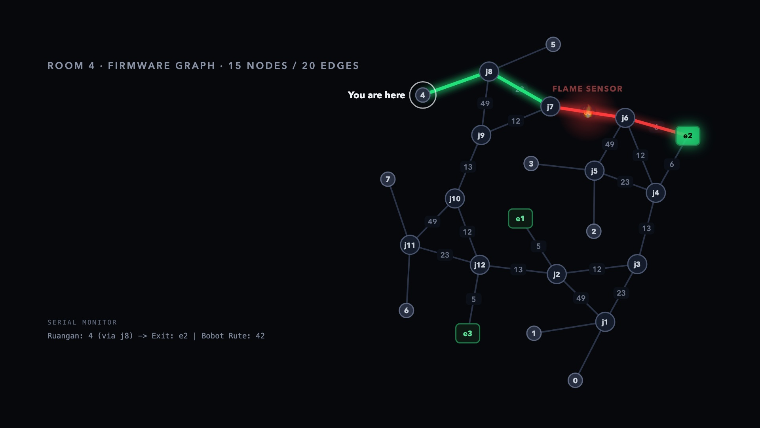
brag-output/work/stills/t12.05.jpg
