aryawiandra/despro-2/brag-output/work/stills/t14.4.jpg

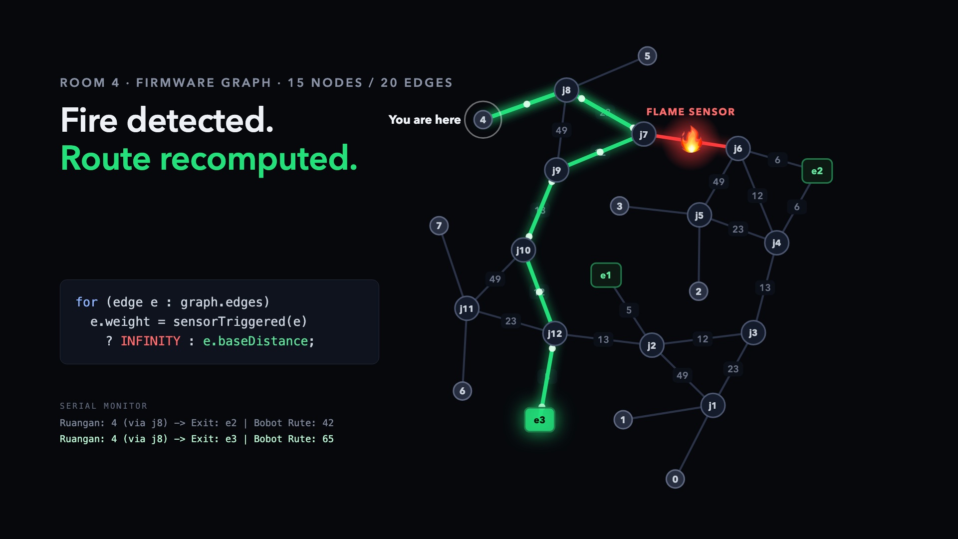
brag-output/work/stills/t14.4.jpg
