aryawiandra/despro-2/brag-output/work/stills/t17.5.jpg

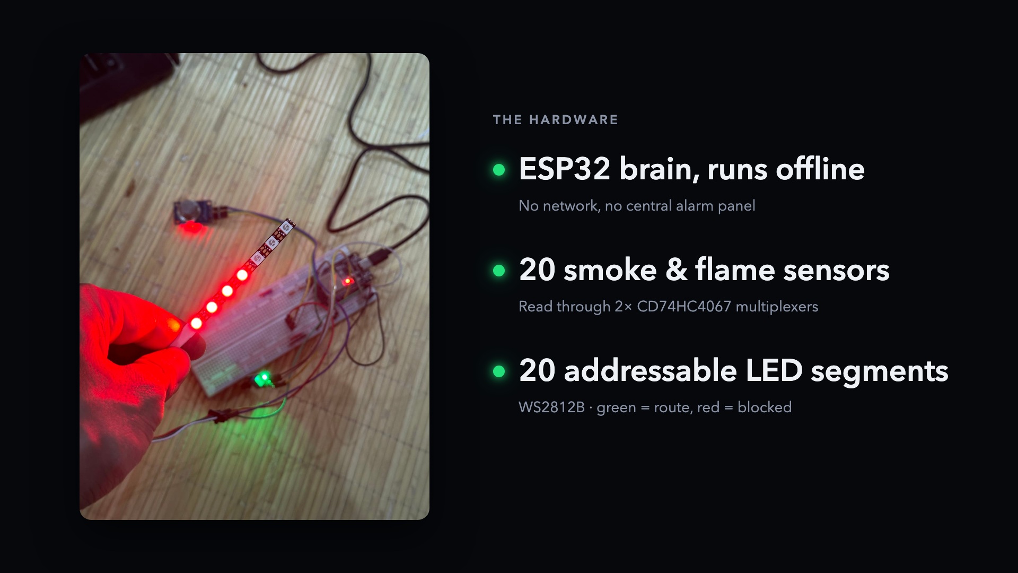
brag-output/work/stills/t17.5.jpg
