aryawiandra/despro-2/brag-output/work/stills/t19.8.jpg

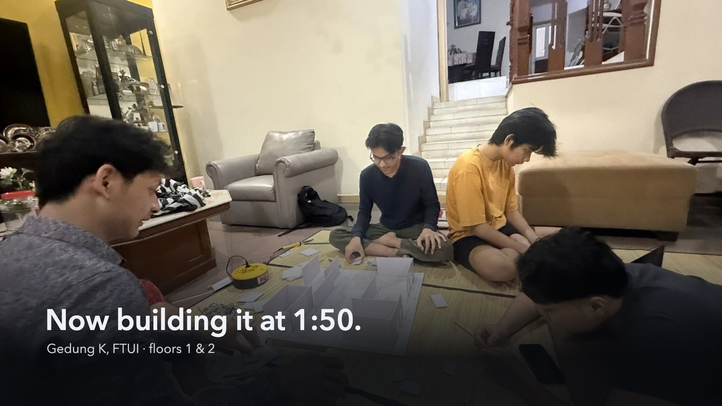
brag-output/work/stills/t19.8.jpg
