aryawiandra/despro-2/brag-output/work/stills/t22.8.jpg

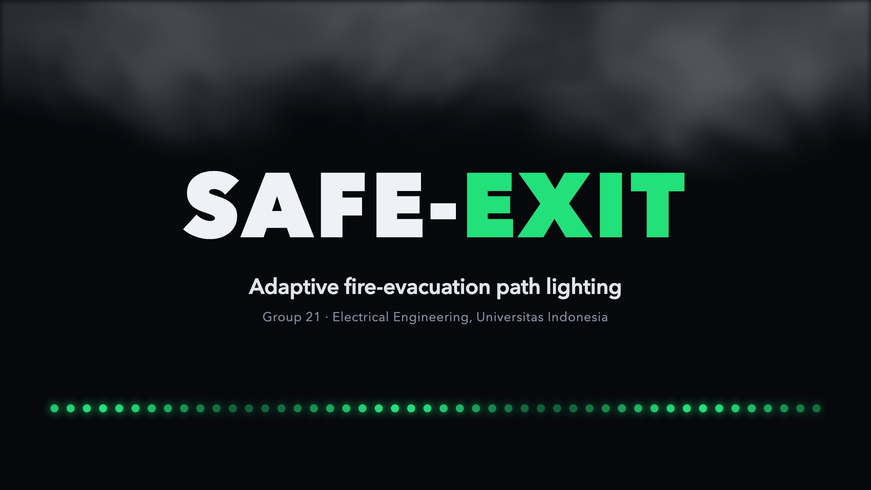
brag-output/work/stills/t22.8.jpg
