aryawiandra/despro-2/(commit log)

2026-10-03 feat: add ESP-NOW sender/receiver sketches for sensor and LED nodes
2026-10-03 ESP-NOW: tambah mode tes tanpa sensor, callback kompatibel core 2.x/3.x, log RX
    Claude-Session: https://claude.ai/code/session_01NkeHeyg8SJMQLF7djeSZBp
2026-10-03 Sender: tambah platformio.ini agar bisa dibuka dan di-upload dari VS Code
    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
2026-10-03 Tes 2 jalur: sender (input simulasi) dan receiver (LED jalur aman)
    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
2026-10-03 Tes 2 jalur receiver: 2 strip dengan pin data terpisah (GPIO 5 dan 18)
    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
2026-10-10 Week7: navigasi 2 jalur dengan LED biasa (pengganti LED strip) + konfigurasi pin
    Claude-Session: https://claude.ai/code/session_01V21pnFtJhVnaMBiBazs7qK
2026-10-10 Week7: Dijkstra 20 jalur (sender teks + receiver jalur hijau, 40 LED per jalur)
    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
2026-10-10 Week7: Dijkstra untuk LED strip WS2812B (20 jalur x 40 LED, nyala sekuensial searah rute)
    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
2026-10-10 Week7: sender dibaca dari 20 sensor api via 2x CD74HC4067 + konfigurasi akhir (pin, daya, tes)
    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
2026-10-10 Week7: 20 sensor langsung ke GPIO tanpa multiplexer, ringkasan rute per ruangan
    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
2026-10-10 Week7: receiver pakai beberapa rantai strip (1 pin per rantai), strip terpisah disambung DOUT-DIN
    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
2026-10-10 Week7: receiver satu pin per jalur (20 pin), driver bit-bang paralel; mode rantai tetap tersedia
    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
2026-10-10 Week7: merah berkedip di receiver 20 jalur; versi 5 jalur (5 pin strip, 5 sensor) + mapping rangkaian dan daya
    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
2026-10-10 Week7: kode 20 jalur dikembalikan seperti semula; merah berkedip hanya di folder dijkstra_5jalur
    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
2026-10-10 Week7: dijkstra_5jalur memakai peta lengkap, strip hanya 5 jalur (j4-e2 6, j6-e2 5, j2-j3 7, j10-j12 8, j7-j9 8 LED), 5 sensor
    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
2026-10-10 Week7/5jalur: sender kirim hanya saat ada perubahan (3x ulang), receiver minta data saat baru menyala, SEND ERROR dibatasi
    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
    [receiver.ino, sender.ino]
2026-10-10 Week7/5jalur: perbaiki error kompilasi PlatformIO (esp_now_recv_info_t tidak ada di core 2.x): callback tanpa #if, signature void*
    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
    [receiver.ino, sender.ino]
2026-10-10 Week7/5jalur: sensor dibaca dari AO (ADC1: GPIO 32-36) dengan ambang + histeresis; strip #19 pindah ke GPIO 18 (tanpa GPIO 16)
    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
2026-10-10 Week7: dijkstra_3jalur (3 strip LED, 3 sensor virtual via input teks)
    Claude-Session: https://claude.ai/code/session_01Bxx7qtE7bYUYEn57HEvgd4
2026-10-10 Week7/3jalur: strip di GPIO 5, 13, 14 dan sensor AO di GPIO 32, 33, 34
    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
2026-10-10 Week7: update laporan kelompok/individu dan PPT ke uji 3 jalur + spesifikasi sensor api
    Claude-Session: https://claude.ai/code/session_01EFAKZhib7CvMuWHfhRrZHZ
2026-10-10 fix: Week7 input api hanya dari sensor AO (ALLOW_TEXT_SIM 0), sesuaikan laporan, PPT, README
2026-10-17 Week7/6jalur: scale ke 6 strip (GPIO 5,13,14,4,18,19) dan 6 sensor AO (GPIO 32,33,34,35,36,39)
    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
2026-10-17 Week7/6jalur: sensor 5-6 pindah ke pin DO digital (GPIO 25, 26); board tanpa GPIO 36/39
    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
